ibro-rox/D4-Ganges/README.md

# D4-Ganges
we are making a sweet quadcopter
