ibro-rox/D4-Ganges/Admin/Module Design Proposals.docx

Module Design Proposals

Module Title: Control Module

People Involved: Lawrence, Ben, Joe

The Control Module is responsible for the main functions of the device, running the main PID control loop and interfacing with the gyroscope and accelerometer. The program loop is designed to be short enough to allow regular updating of motor speeds through PWM control of the ESCs. The base for this module is the ATMEGA32u4 of the Arduino Leonardo, chosen for the wide availability of sensor interface libraries and enough 16-bit timers to allow enough graduation in motor speeds for fine control of the device. This will interface with the Communications module through the UART protocol to receive the user input and will return the motor speed and device orientation for logging and telemetry. The ESCs isolate the high current power circuitry of the motors from the low current micro-controller, taking in low current PWM with a maximum 10% duty cycle and providing the 4 motors with a PWM signal at much higher currents.

Module Title: Sensing Module

People Involved: Ben, Joe

The sensing capabilities of the system is based around the MPU6050 gyroscope/accelerometer IMU and a Sharp GP2Y0A41SK0F infra-red proximity sensor. The MPU6050 has an onboard DMP (Digital Motion Processor) which will be used to relieve load on the Control Module Arduino by converting the raw data from the gyroscope into angles for yaw, pitch and roll on chip, before sending this data over an I2C bus ready for use in the stabilisation algorithm. The Infra-red sensor will be mounted on the base of the drone to detect low flight altitudes and semi-automate the landing procedure. The output of this sensor is an analogue voltage which will be fed into an ADC on the Commnunications Module Il Matto board, as this data is not necessary for stable flight.

Module Title: Communications Module

People Involved: Joel, Mohammed

The Communications module is based around the ATMEGA644p microcontroller on an ‘Il Matto’ breakout board. It functions as the main communications hub of the system, interfacing with the RFM12B-S2 transceivers over SPI to provide the uplink and downlink to the base station and controller. It will perform some basic processing of the instructions from the controller, passing them through to the control module to create a new setpoint for the controller. This interfacing with the command module will be done over UART, and will receive in return logging data from the IMU. This logging data will be periodically written to an SD card sharing the SPI bus and also transmitted back to the base station as telemetry information. The communications microcontroller will also be responsible for reading from the IR proximity sensors through its onboard ADCs and controlling the servo-powered cargo hook through a PWM data signal.

Module Title: Ground Control

People Involved: Mohammed, Joel

The Base Station of the system is formed around the core of another Il Matto ATMEGA644p board. It will take input from the user through a combination of joysticks and buttons on the HID (Human Interface Device) controller. The joysticks contain dual potentiometers, which will be directed into the ADCs of the Il Matto to extract values. There will also be a UART connection to a host PC to be able to update PID constant values without needing to reprogram the command module, as well as to make the display of telemetry and debug information easier to implement and use. The base station will be connected to a RFM12B-S2 radio transceiver module over an SPI bus to allow it to communicate with the quadcopter wirelessly while in flight.
