ibro-rox/D4-Ganges/Admin/presentation/Team_Ganges_Presentation.pptx

## D4 - System Design Exercise Project Itchen

Team Ganges
24/03/2017

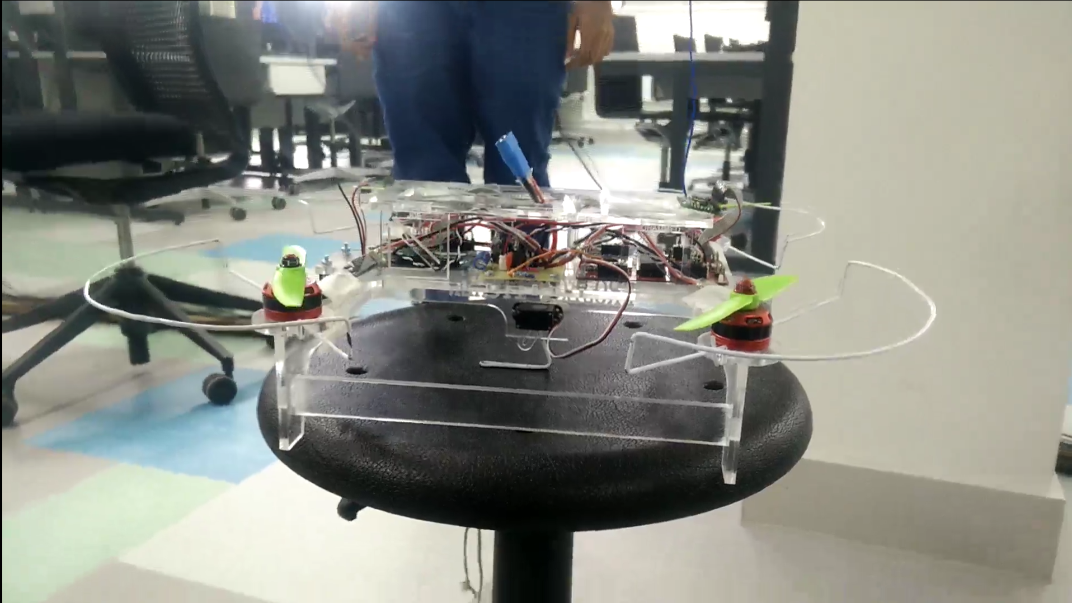
[picture p8: figure]

## Team Ganges

- Lawrence Gray – Control, Chassis Design
- Joe Hindmarsh – Control, Extra Features
- Joel Trickey – Communications, Encryption
- Mohammed Ibrahim – Communications, User Interface
- Ben Rowlinson – Team Leader, Integration

Notes: INSERT TEAM PHOTO HERE!

## The Brief

- “To design and build an unmanned aerial vehicle (UAV) that can pickup, carry and drop-off a cargo”

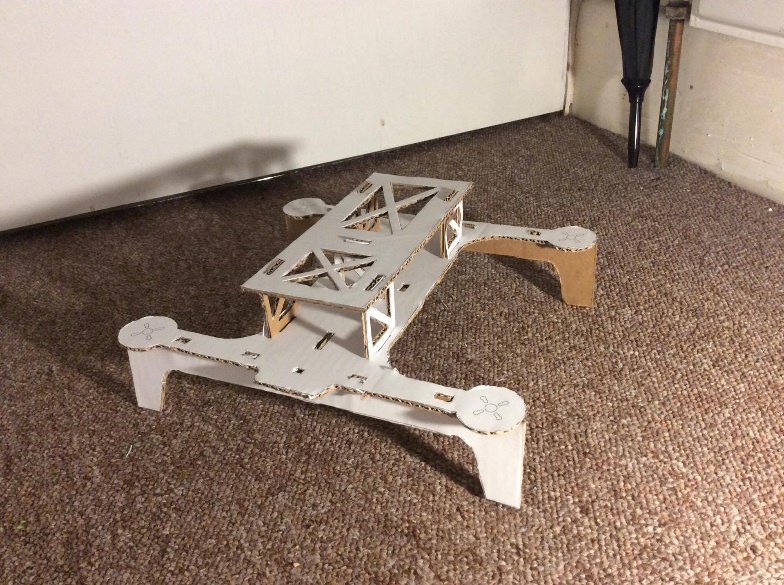
[picture p9: figure]
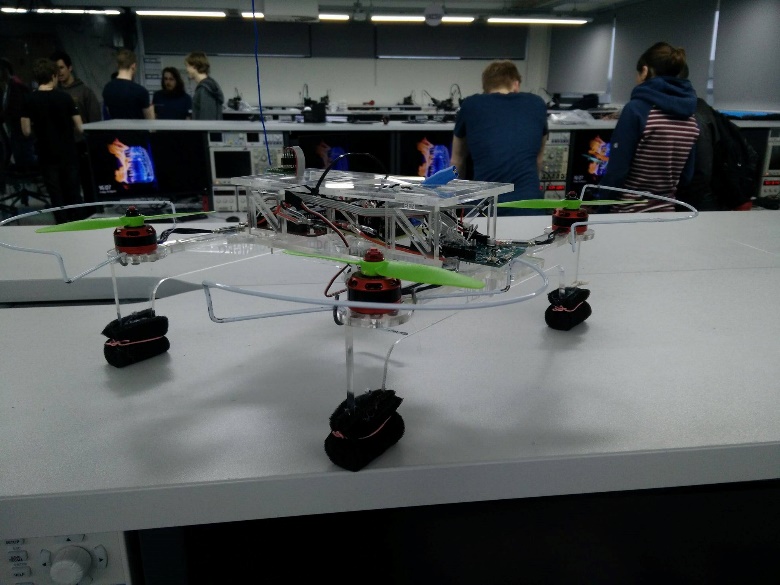
[picture p10: figure]
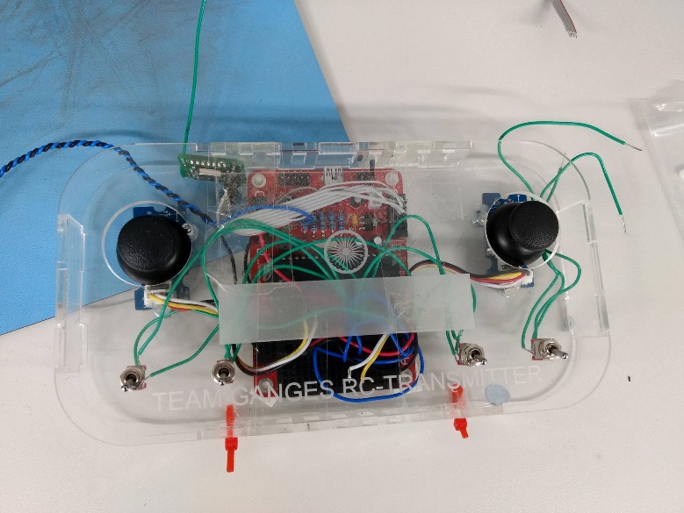
[picture p11: figure]

## Target Market

- Itchen required a solution which:
  - Has good cargo to UAV weight ratio
  - Is safe for the users
  - Is a low cost solution
- We delivered a UAV which incorporates:
  - Custom User interface
  - Two way communications
  - Automated Stabilisation
  - Assisted Cargo Acquisition

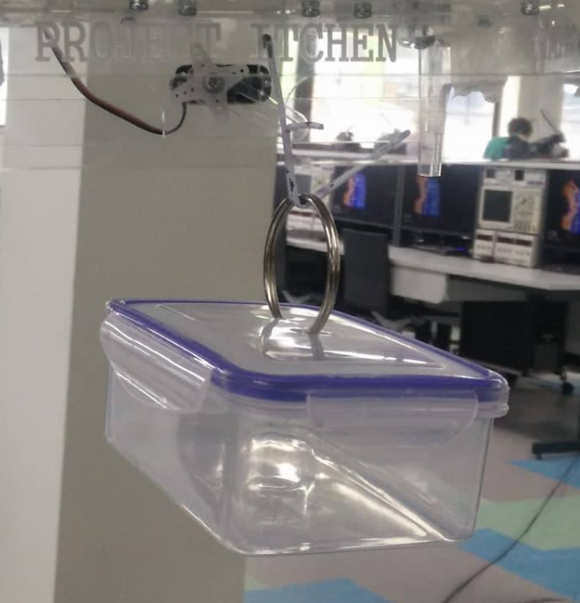
[picture p12: figure]

## Costings

- Retail at £300 gives a profit margin of 46.7%
- 1228 units to be sold to breakeven (at a yield of 90%)
- Expected that more UAVs needed for sustainable wide range delivery network

## Development

- Hardware Sourcing
- Software Development
- Chassis Manufacture
- System Integration
- Full system tuning/testing
- Documentation

## Problems

- Didn’t fly reliably
- Heavy - >900g
- Small Propellers

## Solutions and the Future

- Close to good stability

All image and content acknowledgement to Team Ganges

Notes: With a few more hours of tuning and debugging we could achieve stable flight
