ibro-rox/D4-Ganges/Admin/final_report/D4_Team_Report.pdf

# D4 Team Report

mi3g15

March 2017

## 1 Final Product Section

Table for comparison of achievements with the tasked specifications:

Specifications | Achievements
Arming system for the motors to ensure safety compliance | We made 4 propeller guards from reusable coat hang-ers by reshaping it to the right size and dimension and were proven to be reliable and cost effective.
Motor speed controlled by 1-2ms PWM ESCs - Imax:20 A | Achieved high resolution of motor speed control within 1-2ms using high resolution timers from the leonardo MCU.
RF modules operated using SPI Interface | Achieved this since we were able to receive data that was transmitted from base station il matto to drone il matto. This proves that the SPI works reliably for sending and retrieving data between the il matto and the RF modules.
On-board file logging to SD card | Unable to achieve due to lack of time and coding issues with writing data to the SD card.
I2C interface at 100 samples per sec with Gyroscope and accelerometer(MPU6050) with built in DMP | Achieved reading data from this sensor at the speci-fied rate.
Servo used for cargo acquisition-controlled by PWM | Achieved control of servo using PWM.
Laser- cut arcylic chassis and as-sembled using acrylic glue | Achieved successful construction for initial and final chassis designs.
I-style design for easier weight distribution and more carrying capacity | Achieved implementing this chassis design but in the final product, we added ’I’ supports to the centre as well as to the arms to make the chassis more robust to object/ground collision.
Reprogram the PID controller on the fly by changing K values wirelessly for faster tuning | Program has been developed on the base station to send k values but has be modified for sending these values while the drone is on ground only. Also this method of re tuning has not be used due to risk of a fault in wireless uplink and limited time for tuning of the PID controller.
Interfaced with the pilot using two X-Y joystick potentiometers, a bank of function switches, and a micro-controller | Achieved a remote controller module consisting of these components which has been designed, pro-grammed and tested.
Sharp GP2Y0A41SK0F IR sen-sor providing altitude sensing for telemetry with accuracy from 15 to 100 cm | Sensor has shown to work reliably for the specified range and also implemented receiving IR sensor data for telemetry.

## 2 Working of the Final Product

The remote controller interface consist of joystick potentiometers which are read into the atmega644p MCU using Analogue to Digital converter (ADC) interface. The values are then sent through SPI interface to

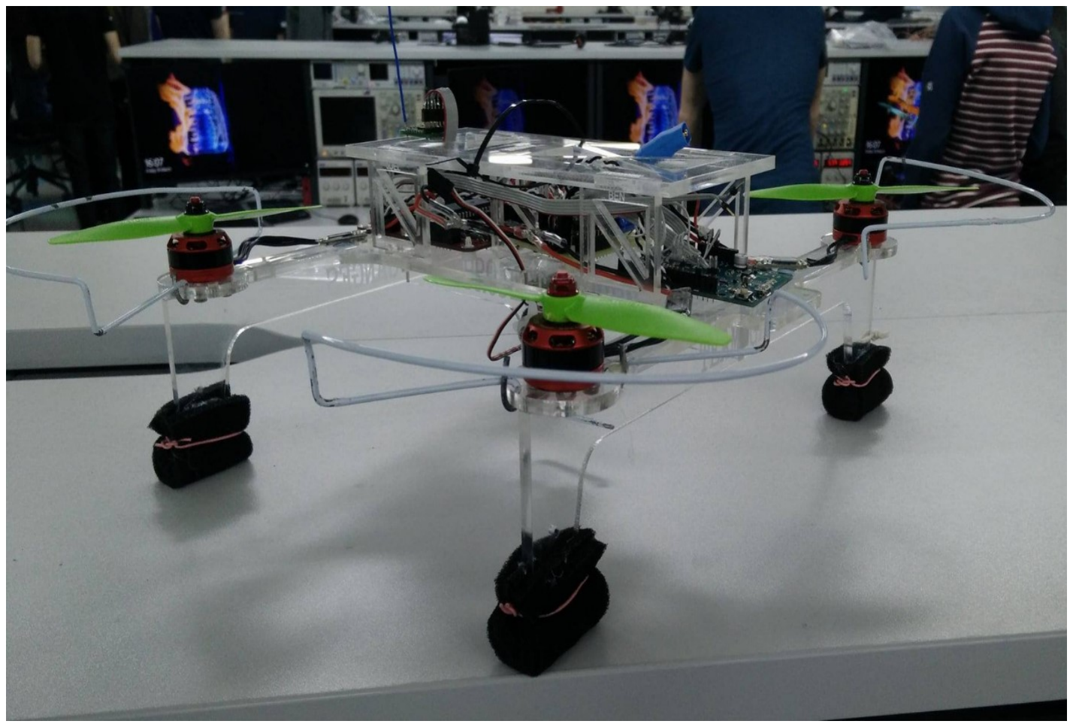
[picture p13: figure]

(a) Final build of the Human drone interface controller with implemented electronics inside an acrylic casing.
(b) Final build of the Quad copter drone consisting of the electronics based on design and specifications, moulded on to the main chassie design.

Figure 1: Final product images

the RF transceiver modules for wireless uplink of the joystick values to the drone. The RF transceiver on the drone then sends the received values to the atmega644p MCU on the drone through the same SPI interface. The same atmega MCU on the drone then sends these values to the arduino leonardo through UART interface. Finally the received joystick values in the leonardo get translated to the corresponding PWM output signals for controlling the speed of the 4 motors. A stabilization controller program is used in the leonardo which reads the data from the accelerometer/gyroscope sensor as feedback to ensure that the drone maintains stable flight. The serial cable in the remote controller is used to view telemetry of the power supply level on the drone and the IR sensor data through PUTTy terminal on the PC when one of the switches is in ’flight mode’ and allows you to enter PID values for yaw, pitch and roll for tuning the stabilization program on the drone when in ’PID mode’.

## 3 Extensions

- One of the features that was not achieved was the logging of telemetry data on to the SD card which could have been achieved if we were provided more time for it.
- Instead of using the PC as a User Interface for telemetry and PID tuning, an LCD screen could have been implemented to make the User interface more localised to the remote.
- Being able to overcome the limitation of the User interface for entering different range of PID values and able to tune the stabilization controller on the drone during its flight.
- Adding IR sensors to the front and bottom of the drone to allow it to detect obstacles and control its motors accordingly to avoid collision.
- Implementing an auto landing feature for the drone to use the bottom IR sensor to land itself safely. The 4th switch on the remote was meant to enable this operation, where when switched on, the drone would reject control commands from the controller and would self land onto ground by accordingly adjusting its motor speed to ensure secure landing.
