ibro-rox/D4-Ganges/Admin/Team_Ganges_Code_Listings.pdf

## 1 Control

## 1.1 Main File

#i n c l u d e ”PWM. h”

#i n c l u d e ”PID . h”

#i n c l u d e ” u t i l s . h”

PID yawPID ( 1 , 0 , 0 ) ; PID p i t c hPID ( 1 , 0 , 0 ) ; PID r o l l P I D ( 1 , 0 , 0 ) ;

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

}

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

// se n d t e l e m e t r y

}

## 1.2 PWM output Funtions

1 | #i n c l u d e ” D e f i n i t i o n s . h”
2 | #i n c l u d e ”PWM. h”
3 | #i n c l u d e ”A r d ui n o . h”
4 | v o i d i n i t p wm ( v o i d )
5 | {
6 | /∗ TIMER 1 ∗/
7 | DDRB |= | BV (PB5 ) ; /∗ PWM 1A o u t ( p i n 9 on p r o mi c r o ) ∗/
8 | DDRB |= | BV (PB6 ) ; /∗ PWM 1B o u t ( p i n 10 on p r o mi c r o ) ∗/
9 | DDRB |= | BV (PB7 ) ; /∗ PWM 1C o u t ( non e x i s t a n t on p r o mi c r o ) ∗/
10 | TCCR1A = | BV (WGM11) | /∗ f a s t PWM/MAX ∗/
11 | BV (WGM12) | /∗ f a s t PWM/MAX ∗/
12 | BV (WGM13) | /∗ f a s t PWM/MAX ∗/
13 | BV (COM1A1) | /∗ A o u t p u t e n a b l e d ∗/
14 | BV (COM1B1) | /∗ C o u t p u t e n a b l e d ∗/
15 | BV (COM1C1) ; /∗ B o u t p u t e n a b l e d ∗/
16 | TCCR0B = | BV ( CS11 ) | ; /∗ /8 p r e s c a l i n g ∗/
17 | ICR1 = TIMER TOP ;
18 | /∗ TIMER 3 ∗/
19 | DDRC |= | BV (PC6 ) ; /∗ PWM 3A o u t ( p i n 5 on p r o mi c r o ) ∗/
20 | TCCR3A = | BV (WGM31) | /∗ f a s t PWM/MAX ∗/
21 | BV (WGM32) | /∗ f a s t PWM/MAX ∗/
22 | BV (WGM33) |
23 | BV (COM3A1) ; /∗ A o u t p u t e n a b l e d ∗/
24 | TCCR3B = | BV ( CS31 ) | ;
25 | ICR3 = TIMER TOP ;
26 | pwm duty (LEFT FRONT MOTOR, MIN MOTOR SPEED) ;
27 | pwm duty (RIGHT FRONT MOTOR, MIN MOTOR SPEED) ;
28 | pwm duty (LEFT REAR MOTOR, MIN MOTOR SPEED) ;
29 | pwm duty (RIGHT REAR MOTOR, MIN MOTOR SPEED) ;
30 | }

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

38
39 | s w i t c h ( motor )
40 | {
41 | c a s e LEFT FRONT MOTOR:
42 | OCR1A = d u ty ;
43 | c a s e RIGHT FRONT MOTOR:
44 | OCR1B = d u ty ;
45 | c a s e LEFT REAR MOTOR:
46 | OCR1C = d u ty ;
47 | c a s e RIGHT REAR MOTOR :
48 | OCR3A = d u ty ;
49 | }
50 | }

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

62 | CCW m o t o r s | D,B

63
64 | | F r o n t
65 | | +1 p i t c h
66 | C | D
67 | −1 r o l l | \−/ | +1 r o l l | r i g h t
68 | | /−\
69 | B | A
70 | | −1 p i t c h

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

## 1.3 PID Class (Found online)

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

20
21 | //#i n c l u d e ”WProgram . h”
22 | #i n c l u d e ”PID . h”

23
24 | PID : : PID ( ) {
25 | i S t a t e = 0 ;
26 | l a s t = 0 ;

27
28 | p g a i n = 0 ;
29 | i g a i n = 0 ;
30 | d g a i n = 0 ;
31 | }

32
33 | PID : : PID ( f l o a t p , f l o a t i , f l o a t d ) {
34 | PID ( ) ;

35
36 p g a i n = p ;

37 | i g a i n = i ;
38 | d g a i n = d ;
39 | }

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

}

v o i d PID : : r e s e t E r r o r ( ) {
i S t a t e = 0 ;

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

## 1.4 Other utilities for PID code

#i n c l u d e ” u t i l s . h”

#i n c l u d e ” D e f i n i t i o n s . h”

f l o a t rawToAngle ( i n t c o n t r o l I n )

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

}

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

}
r e t u r n 0 ;

}

## 2 Sensing

## 2.1 Gyroscope (example code we will use for getting angles from gyro)

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

33
34 | THE SOFTWARE I S PROVIDED ”AS I S ” , WITHOUT WARRANTY OF ANY KIND , EXPRESS OR
35 | IMPLIED , INCLUDING BUT NOT LIMITED TO THE WARRANTIES OF MERCHANTABILITY,
36 | FITNESS FOR A PARTICULAR PURPOSE AND NONINFRINGEMENT. IN NO EVENT SHALL THE
37 | AUTHORS OR COPYRIGHT HOLDERS BE LIABLE FOR ANY CLAIM , DAMAGES OR OTHER
38 | LIABILITY , WHETHER IN AN ACTION OF CONTRACT, TORT OR OTHERWISE, ARISING FROM,
39 | OUT OF OR IN CONNECTION WITH THE SOFTWARE OR THE USE OR OTHER DEALINGS IN
40 | THE SOFTWARE.
41 | ===============================================
42 | ∗/

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

63

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

| b o o l b l i n k S t a t e = f a l s e ;

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

141
142 | // p a c k e t s t r u c t u r e f o r I n v e n S e n s e t e a p o t demo
143 | u i n t 8 t t e a p o t P a c k e t [ 1 4 ] = { ’ $ ’ , 0 x02 , 0 , 0 , 0 , 0 , 0 , 0 , 0 , 0 , 0 x00 , 0 x00 , ’ \ r ’ , ’ \n
| ’ } ;

144

145

146
147 | // ================================================================
148 | // === | INTERRUPT DETECTION ROUTINE | ===
149 | // ================================================================

150

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

156

157

158
159 | // ================================================================
160 | // === | INITIAL SETUP | ===
161 | // ================================================================

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

pinMode (INTERRUPT PIN , INPUT ) ;

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

}

// c o n f i g u r e LED f o r o u t p u t pinMode ( LED PIN , OUTPUT) ;

}

// ================================================================
248 | // === | MAIN PROGRAM LOOP | ===
// ================================================================
| v o i d l o o p ( ) {

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

// .

// .

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

// .

// .

// .

}

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

#i f d e f OUTPUT READABLE QUATERNION

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

#i f d e f OUTPUT READABLE EULER

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

#i f d e f OUTPUT READABLE YAWPITCHROLL

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

#i f d e f OUTPUT READABLE REALACCEL

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

#i f d e f OUTPUT READABLE WORLDACCEL

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

## 2.2 IR sensor

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

9
10 | v o i d i n i t a d c ( v o i d )
11 | {
12 | ADCSRA |= | BV (ADPS2) | | BV (ADPS1) | | BV (ADEN) ;
13 | ADMUX |= | BV (REFS0 ) ;
14 | }

15
16 | u i n t 1 6 t r e a d a d c ( v o i d )
17 | {
18 | ADCSRA |= | BV (ADSC) ;
19 | w h i l e (ADCSRA & BV (ADSC) ) ;

20
21 | r e t u r n ADC;
22 | }

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

39
40 | f o r ( ; ; )
41 | {
42 | | r e s u l t = r e a d a d c ( ) ;

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

48
49 | | d e l a y m s ( 1 0 0 0 ) ;
50 | }
51 | }

## 3 Communication

## 3.1 Communications Code from Base station

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

8
9 u i n t 8 t e n c r y p t i o n k e y ;

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

16
17 e n c r y p t i o n k e y = 5 ;

18
19 | // Send t e s t da ta
20 | u i n t 1 6 t t e s t d a t a = 0 ;

21
22 | w h i l e ( 1 )
23 | {
24 | | r f m 1 2 t i c k ( ) ;

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

32
33 | }
34 | w h i l e ( 1 ) { } ;
35 | }

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

∗/
v o i d S e n d da ta ( u i n t 8 t ty pe , u i n t 1 6 t da ta )

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

// E n c r y p t da ta
#i f ENCRYPTION ENABLED

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

}

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

| }

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

| }

## 3.2 Communications code from the drone

#i n c l u d e <a v r / i o . h>

#i n c l u d e <a v r / i n t e r r u p t . h>

#i n c l u d e <u t i l / d e l a y . h>

#i n c l u d e ” r fm12 . h”

#i n c l u d e ” drone comms . h”

i n t main ( v o i d )

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

w h i l e ( 1 )

{
r f m 1 2 t i c k ( ) ;

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

#i f UPLINK TEST

// Send da ta t o UART
#e n d i f

}

}

}

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

#i f ENCRYPTION ENABLED

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

}

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

## 3.3 Packet encryption and encoding

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

6
7 | // Mohammed ’ s UART code
8 | #d e f i n e BAUD 9600 | | // d e f i n e baud
9 | #d e f i n e BAUDRATE ( ( F CPU ) / (BAUD∗16UL) −1) | // s e t baud r a t e v a l u e f o r
| UBRR

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

20
21 | UCSR0C = BV ( UCSZ00 ) | | BV ( UCSZ01 ) ; // 8 b i t s , USBS1 = 0 f o r 1 s t o p b i t

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

32 | UDR0 = da ta ;
33 | }

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

40
41 | v o i d t e s t e n c o d e ( )
42 | {
43 | // Encode
44 | s e n d s t r i n g ( ” E nc o di n g da ta \n” ) ;
45 | // 998 = 11 1110 0110
46 | u i n t 1 6 t ADCoutput ;
47 | ADCoutput = 9 9 8;
48 | // 1110 0110
49 | u i n t 8 t l s b 8 ;
50 | l s b 8 = ADCoutput ;
51 | // 11 0000 0000
52 | u i n t 1 6 t msb2 ;
53 | msb2 = ADCoutput − l s b 8 ;
54 | // 00 0000 0011
55 | msb2 = msb2 >> 8 ;
56 | // 0000 1011
57 | u i n t 8 t p a c k e t t y p e ;
58 | p a c k e t t y p e = ( 2 << 2 ) + msb2 ;

59
60 // Se n t da ta : [ 0 0 0 0 1 0 1 1] [ 1 1 1 0 0 1 1 0]

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

72
73 | c h a r sendDa ta [ 3 0 ] ;
74 | s p r i n t f ( sendData , ”Decoded da ta : %d\n” , d e c o d e d da ta ) ;
75 | s e n d s t r i n g ( sendDa ta ) ;
76 | }

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

138
139 | i n t main ( v o i d )
140 | {
141 | i n i t u a r t 1 ( ) ;

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

152 }

153
154 | w h i l e ( 1 ) { } ;
155 | }

## 4 Ground Control

## 4.1 Testing adc reads for using Joystick potentiometers

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

22

23
24 | // I n ADCSRA E na bl e ADC ( s e t ADEN) and p r e s c a l e r o f 64
25 | ADCSRA |= | BV (ADEN) | | BV (ADPS2) | | BV (ADPS1) ;
26 | }
27 | u i n t 1 6 t a d c r e a d ( i n t n ) // [ 1 ]
28 | {
29 | ADMUX = n ; // r e p r e s e n t s PA2
30 | // s t a r t c o n v e r s i o n
31 | ADCSRA |= | BV (ADSC) ;
32 | // w a i t f o r c o n v e r s i o n t o c om pl e t e
33 | // w h i l e ( ! (ADCSRA & BV(ADIF) ) ) { } ;
34 | w h i l e (ADCSRA & BV (ADSC) ) ;
35 | ADC = (ADCH << 8 ) | ADCL; // [ 1 ]
36 | r e t u r n ADC;
37 | }
38 | #d e f i n e BAUD 9600 | // d e f i n e baud
39 | #d e f i n e BAUDRATE ( ( F CPU ) / (BAUD∗16UL) −1) | // s e t baud r a t e v a l u e f o r
| UBRR

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

50
51 | UCSR0C = BV ( UCSZ00 ) | | BV ( UCSZ01 ) ; // 8 b i t s , USBS1 = 0 f o r 1 s t o p b i t

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

}

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

134
135 | }
136 | }

## 4.2 Testing User Interface code in the base station controler

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

15
16 | #d e f i n e PWM DUTY MAX 240
17 | #d e f i n e PWM DUTY MIN 0
18 | #d e f i n e PWM PRESCALER 8UL
19 | #d e f i n e PWM FREQUENCY 50
20 | #d e f i n e PWM OFFSET 0
21 | // ∗∗∗∗∗∗∗∗∗∗

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

26
27 | // I n ADCSRA E na bl e ADC ( s e t ADEN) and p r e s c a l e r o f 64
28 | ADCSRA |= | BV (ADEN) | | BV (ADPS2) | | BV (ADPS1) ;
29 | }
30 | v o i d i n i t p wm ( v o i d )
31 | {
32 | /∗ TIMER 2 ∗/

33 | DDRD |= | BV (PD6) ; /∗ PWM o u t ∗/
34 | DDRD |= | BV (PD7) ; /∗ i n v . PWM o u t ∗/

35

36
37 | TCCR2A = BV (WGM20) | /∗ f a s t PWM/MAX ∗/
38 | BV (COM2A1) ; /∗ A o u t p u t ∗/
39 | TCCR2B = BV ( CS21 ) | |
40 | BV ( CS22 ) ; | /∗ 1/256 p r e s c a l i n g ∗/
41 | }
42 | u i n t 1 6 t a d c r e a d ( i n t n ) // [ 1 ]
43 | {
44 | ADMUX = n ; // r e p r e s e n t s PA2
45 | // s t a r t c o n v e r s i o n
46 | ADCSRA |= | BV (ADSC) ;
47 | // w a i t f o r c o n v e r s i o n t o c om pl e t e
48 | // w h i l e ( ! (ADCSRA & BV(ADIF) ) ) { } ;
49 | w h i l e (ADCSRA & BV (ADSC) ) ;
50 | ADC = (ADCH << 8 ) | ADCL; // [ 1 ]
51 | r e t u r n ADC;
52 | }
53 | v o i d pwm duty ( u i n t 8 t d u ty ) // f rom s e r v o . c
54 | {
55 | d u ty = d u ty > PWM DUTY MAX ? PWM DUTY MAX : d u ty ;
56 | d u ty = d u ty < PWM DUTY MIN ? PWM DUTY MIN : d u ty ;
57 | // p r i n t f ( ”\nPWM=%3u | ==> | ” , d u ty ) ;
58 | OCR2A = d u ty ;
59 | }
60 | v o i d i n i t u a r t 1 ( ) // i n i t i a l i z e UART
61 | {
62 | // 1 . s e t t h e baud r a t e , l e t s c o n f i g u r e t o 9 6 0 0;
63 | // s e t t h e baud r a t e r e g i s t e r s Re f : [ 1 ] , [ 2 ]
64 | UBRR0H = BAUDRATE >> 8 ; // UBRRnH i s 8 b i t s l e f t
65 | UBRR0L = BAUDRATE;

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

69
70 | UCSR0C = BV ( UCSZ00 ) | | BV ( UCSZ01 ) ; // 8 b i t s , USBS1 = 0 f o r 1 s t o p b i t

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

144
145 }

146
147 | i n t main ( )
148 | {
149 | i n i t u a r t 1 ( ) ;

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

161
162 | w h i l e ( 1 )
163 | {

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

200

201
202 | }
203 | }

## 5 Chassis Design

## 5.1 Servo code for hook

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

9

10

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

15
16 | #d e f i n e PWM DUTY MAX 240
17 | #d e f i n e PWM DUTY MIN 0
18 | #d e f i n e PWM PRESCALER 8UL
19 | #d e f i n e PWM FREQUENCY 50
20 | #d e f i n e PWM OFFSET 0

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

27
28 | i n t main ( v o i d )
29 | {

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

34
35 | u i n t 1 6 t a d c v a l u e ;
36 | u i n t 8 t pwm value ;

37
38 | w h i l e ( 1 )
39 | {
40 | a d c v a l u e = a d c r e a d ( ) ;
41 | pwm value = ( u i n t 8 t ) ( a d c v a l u e / 4 ) + PWM OFFSET;
42 | pwm duty ( pwm value ) ;
43 | d e l a y m s ( 1 0 0 ) ;
44 | }
45 | }

46

47

48
49 | v o i d i n i t p wm ( v o i d )
50 | {
51 | /∗ TIMER 2 ∗/
52 | DDRD |= | BV (PD6) ; /∗ PWM o u t ∗/
53 | DDRD |= | BV (PD7) ; /∗ i n v . PWM o u t ∗/

54

55
56 | TCCR2A = BV (WGM20) | /∗ f a s t PWM/MAX ∗/
57 | BV (COM2A1) ; /∗ A o u t p u t ∗/
58 | TCCR2B = BV ( CS21 ) | |
59 | BV ( CS22 ) ; | /∗ 1/256 p r e s c a l i n g ∗/
60 | }

61
62 v o i d pwm duty ( u i n t 8 t d u ty )

63 | {
64 | d u ty = d u ty > PWM DUTY MAX ? PWM DUTY MAX : d u ty ;
65 | d u ty = d u ty < PWM DUTY MIN ? PWM DUTY MIN : d u ty ;
66 | p r i n t f ( ”\nPWM=%3u | ==> | ” , d u ty ) ;
67 | OCR2A = d u ty ;
68 | }

69
70 | v o i d i n i t a d c ( v o i d )
71 | {
72 | /∗ REFSx = 0 : S e l e c t AREF a s r e f e r e n c e
73 | ∗ ADLAR = 0 : R i g h t s h i f t r e s u l t
74 | ∗ | MUXx = 0 : D e f a u l t t o c h a n n e l 0
75 | ∗/
76 | ADMUX = 0 x00 ;
77 | /∗ | ADEN = 1 : E na bl e t h e ADC
78 | ∗ ADPS2 = 1 : C o n f i g u r e ADC p r e s c a l e r
79 | ∗ ADPS1 = 1 : F ADC = F CPU / 64
80 | ∗ ADPS0 = 0 : | = 1 8 7. 5 kHz
81 | ∗/
82 | ADCSRA = BV (ADEN) | | BV (ADPS2) | | BV (ADPS1) ;
83 | }

84

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

95
96 | p r i n t f ( ”ADC=%4d” , a d c i n ) ;

97
98 | r e t u r n a d c i n ;
99 | }

## 5.2 Laser printing design

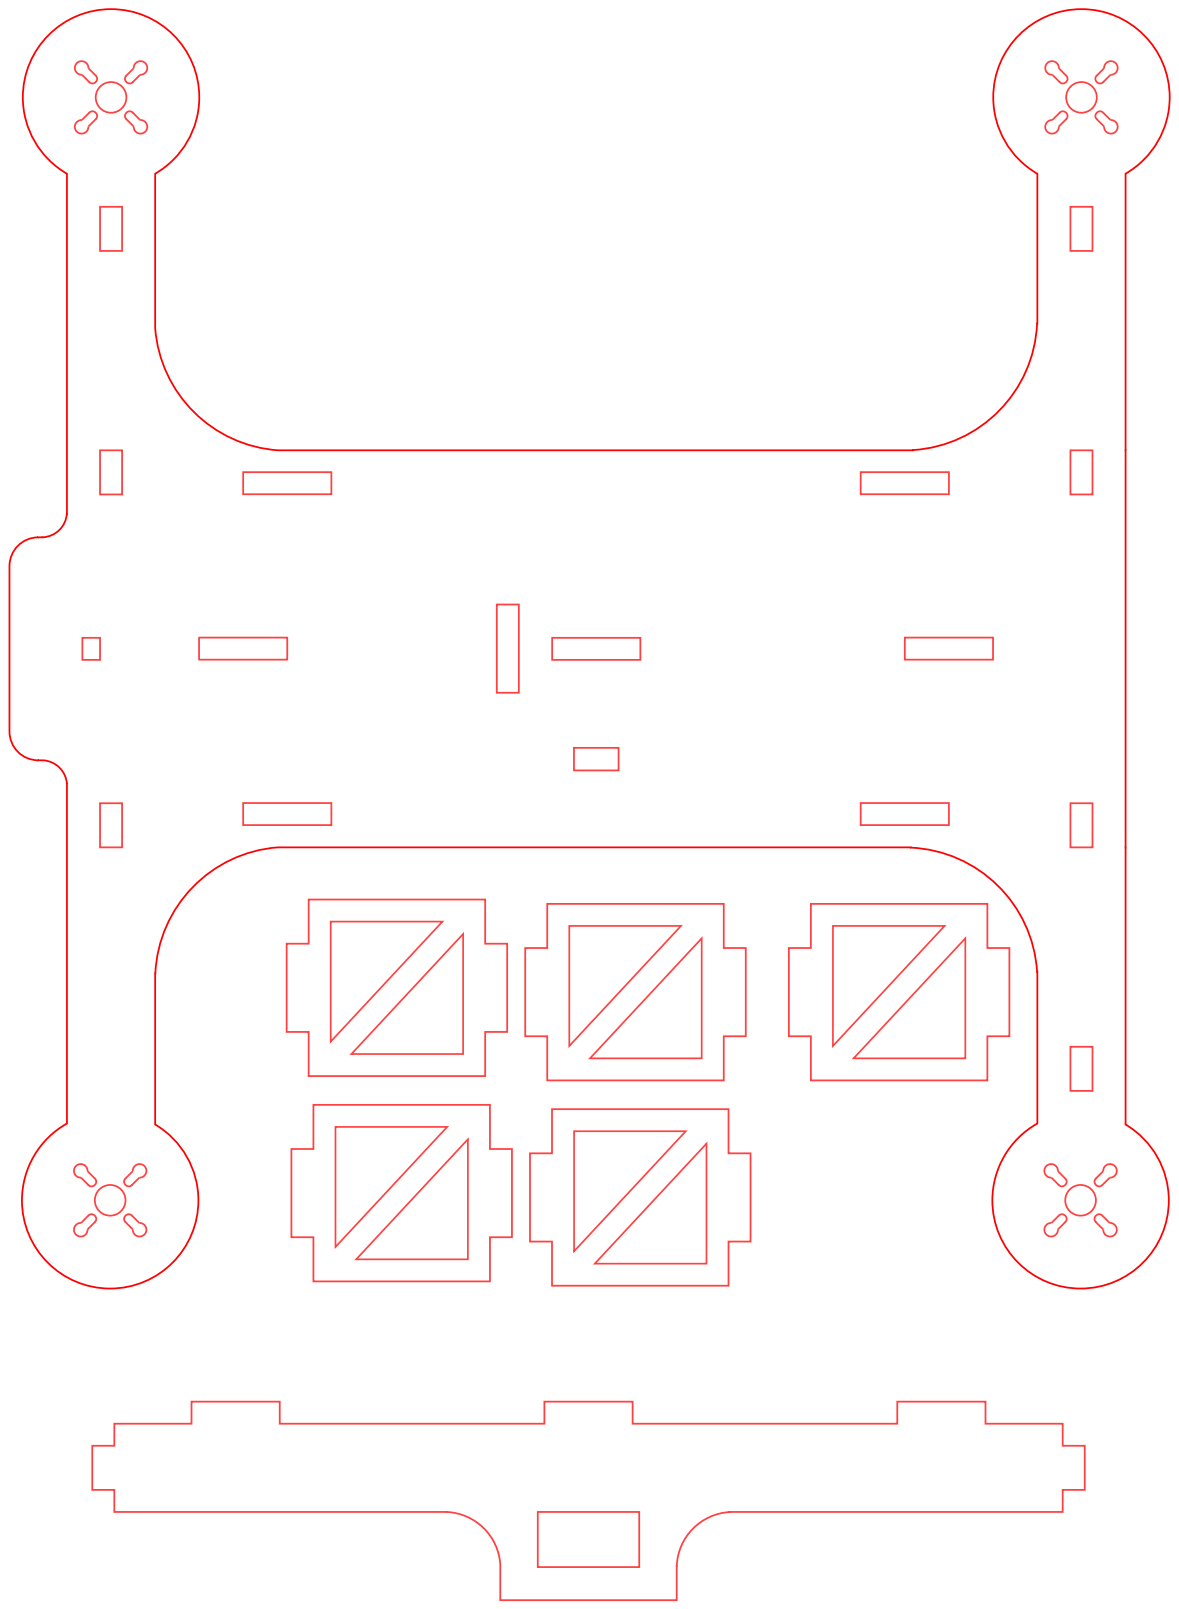
[picture p20: page 27]

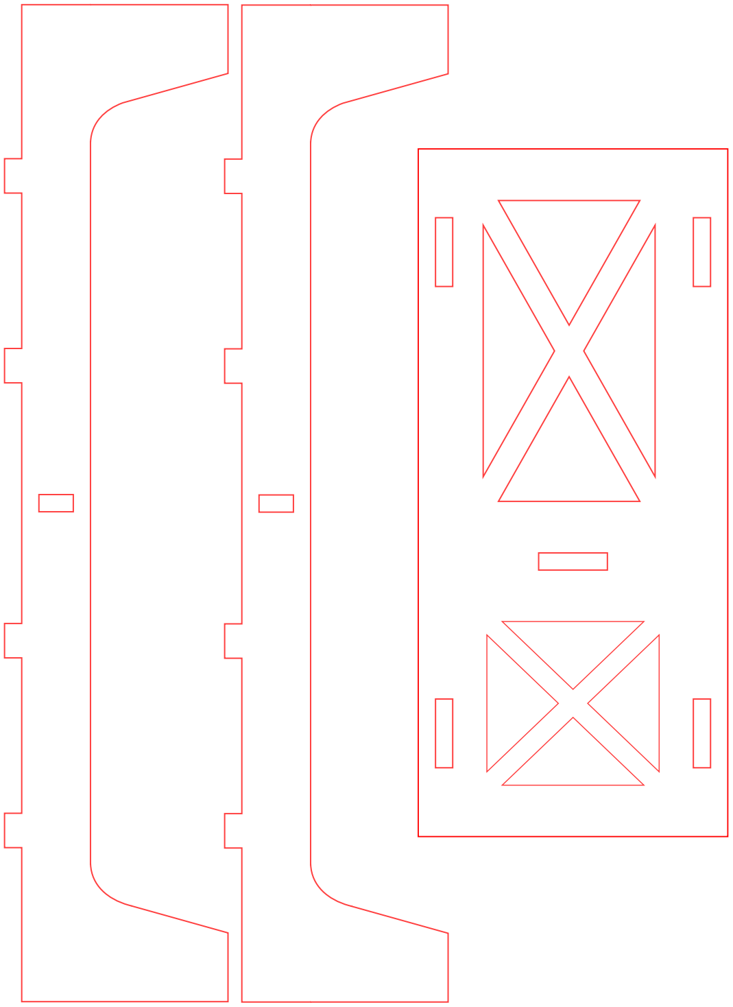
[picture p21: figure]
