ibro-rox/D4-Ganges/Admin/final_report/PCF1.pdf

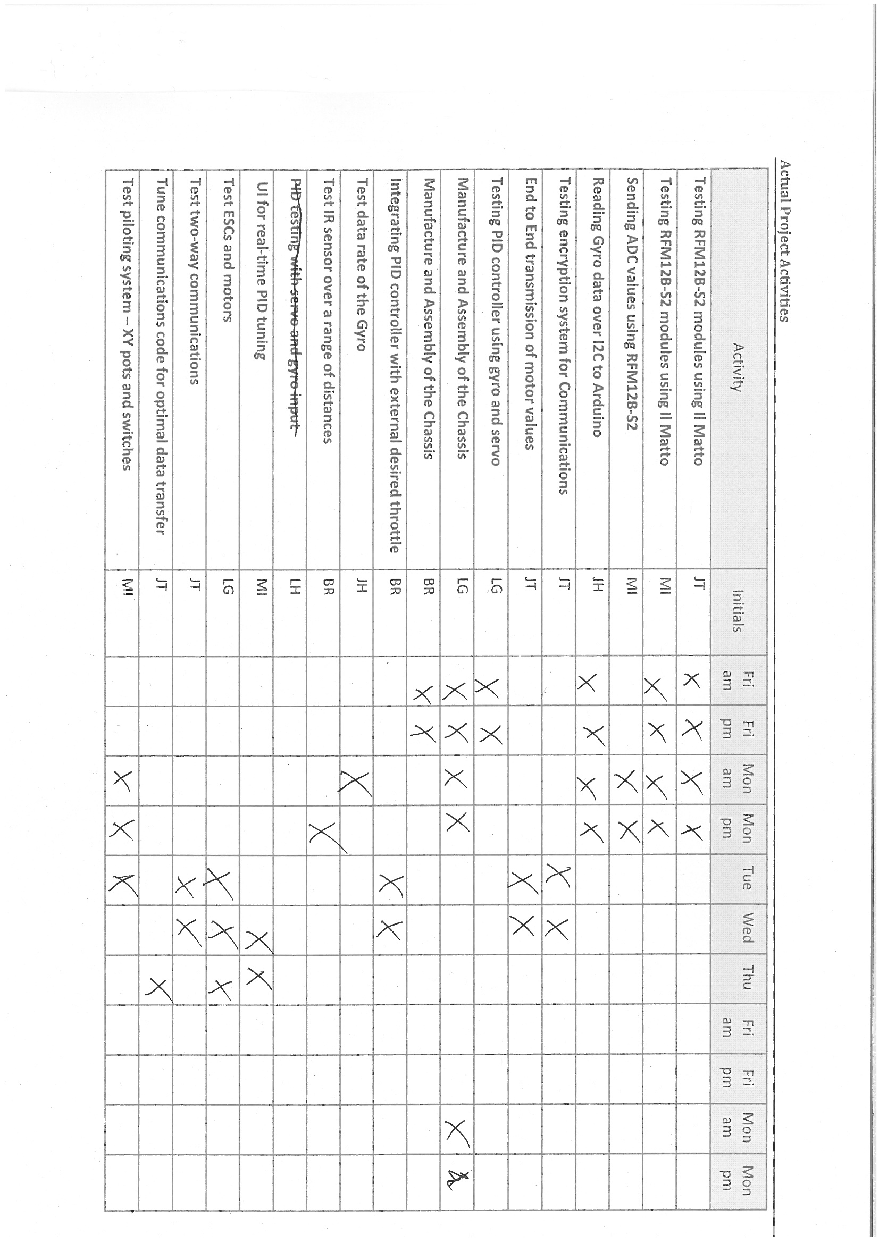
[picture p22: page 1]
