ibro-rox/D4-Ganges/Admin/final_report/PCF2.pdf

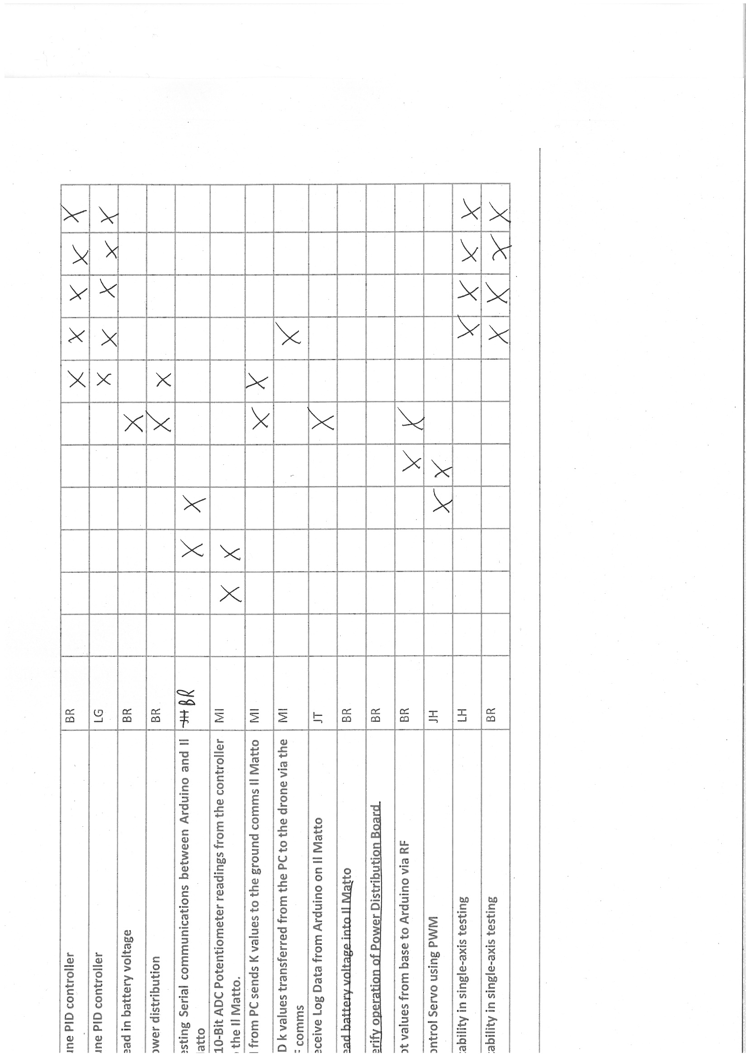
[picture p23: page 1]
