ibro-rox/D4-Ganges/Admin/final_report/Design_Completion1.pdf

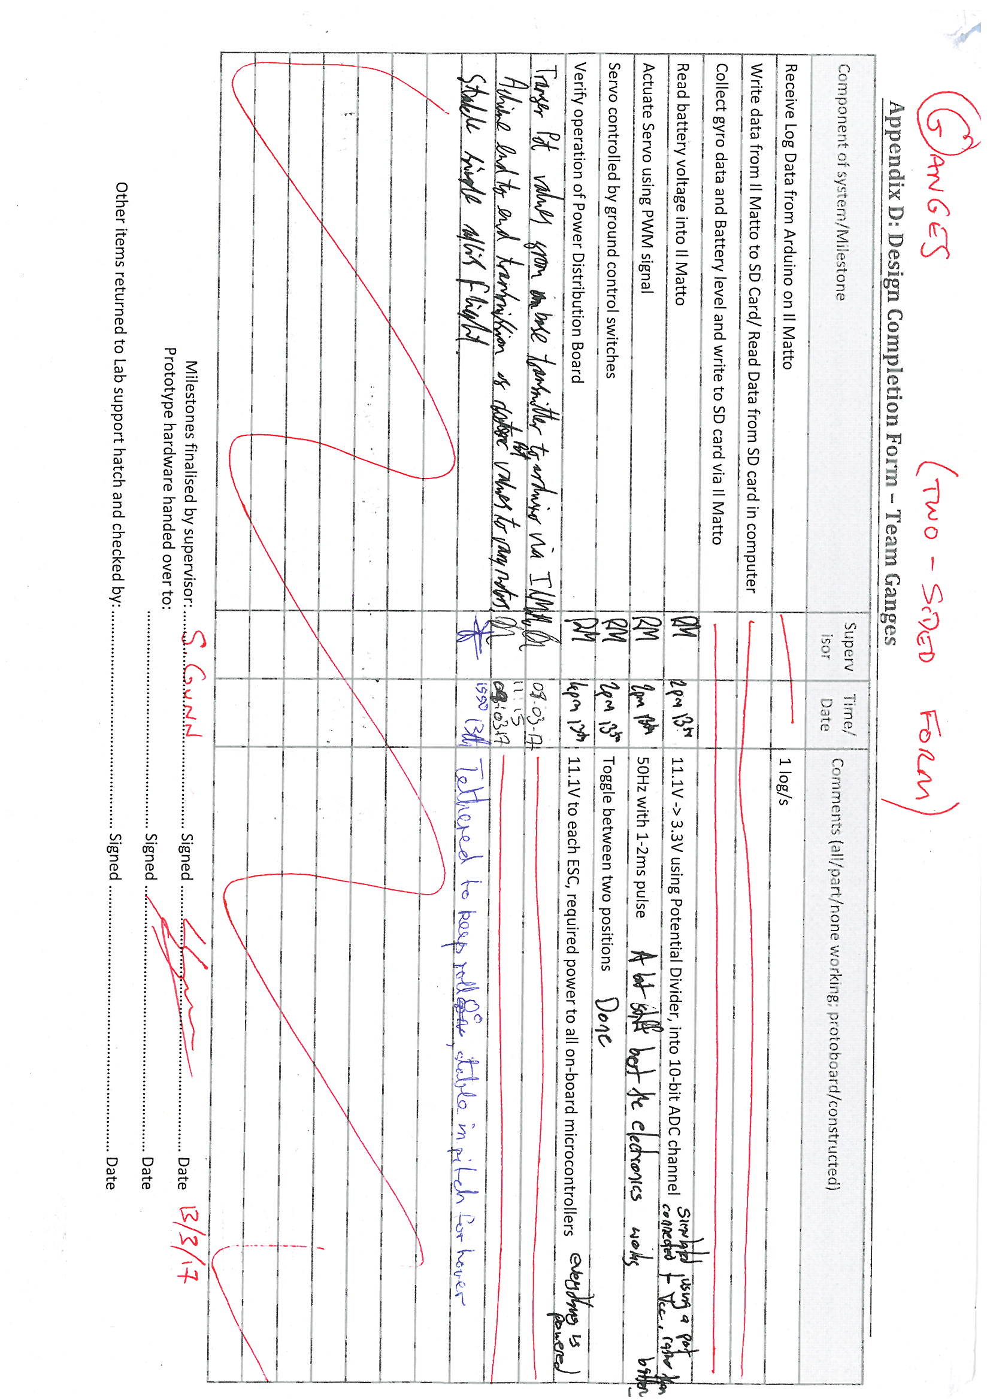
[picture p24: page 1]
