ibro-rox/D4-Ganges/Admin/final_report/Design_Completion2.pdf

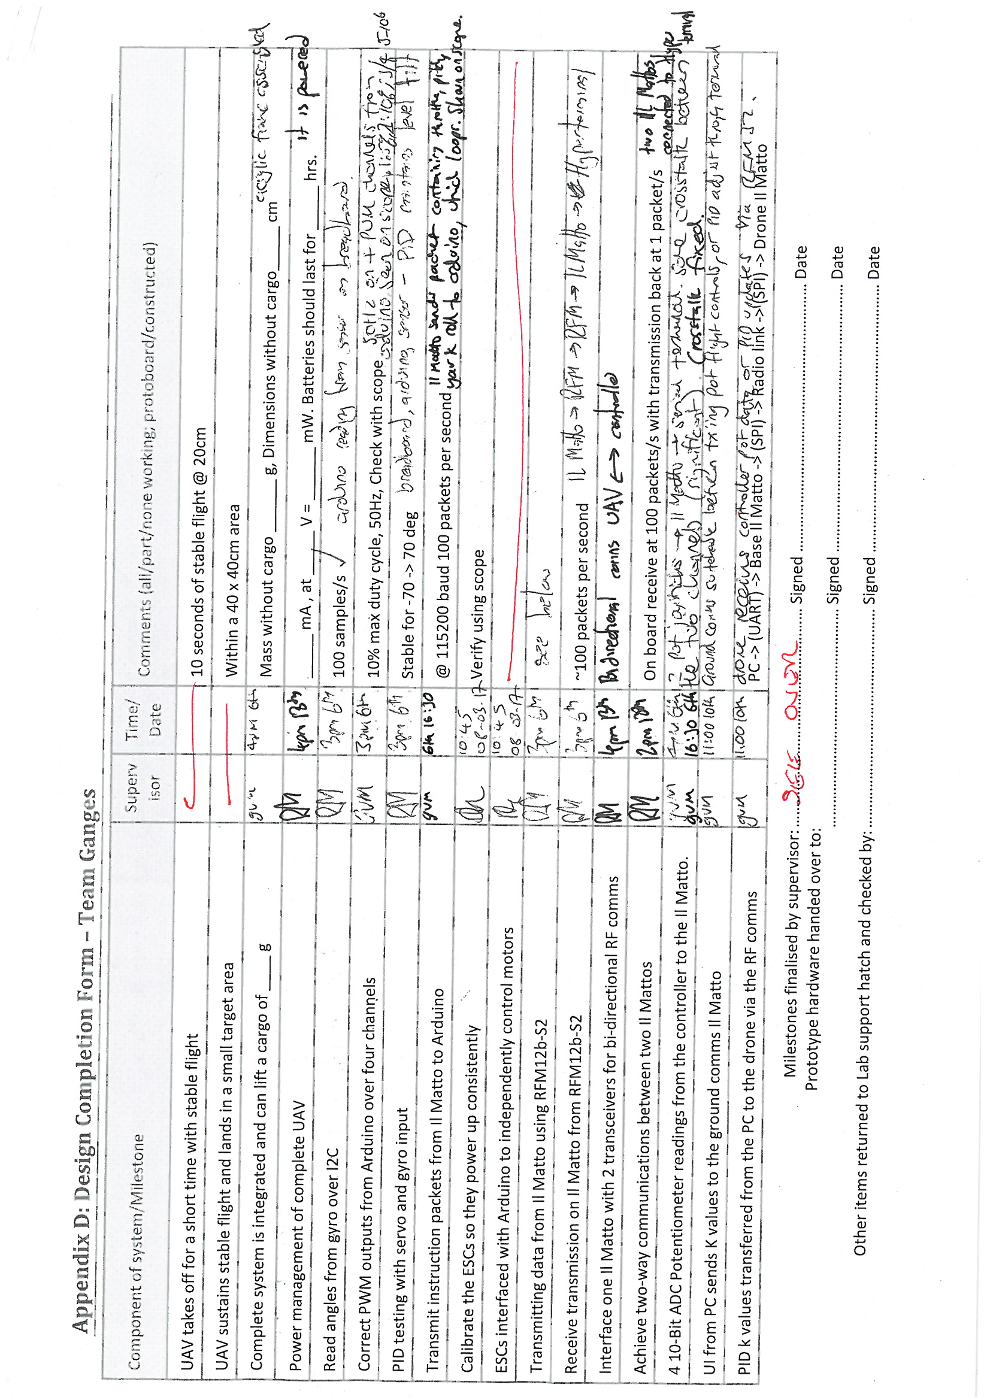
[picture p25: page 1]
