ibro-rox/D4-Ganges/Admin/final_report/Ben/57600_baud_1_char_y.png

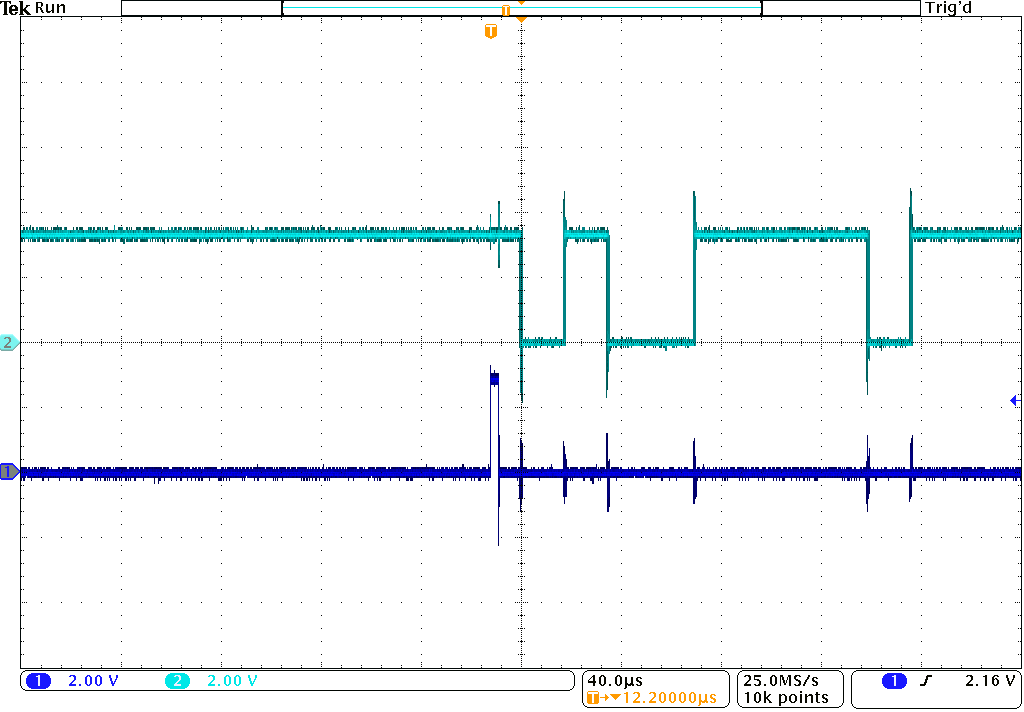
Admin/final_report/Ben/57600_baud_1_char_y.png
