ibro-rox/D4-Ganges/Admin/final_report/Ben/57600_baud_3_dig_512.png

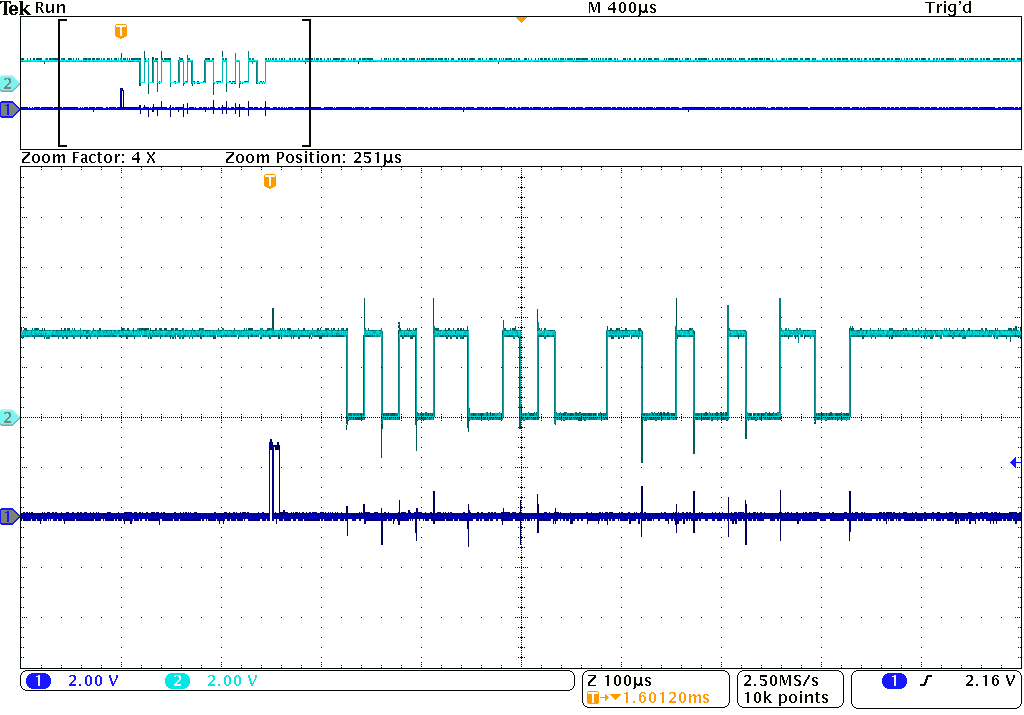
Admin/final_report/Ben/57600_baud_3_dig_512.png
