ibro-rox/D4-Ganges/Joe/i2c protocol.PNG

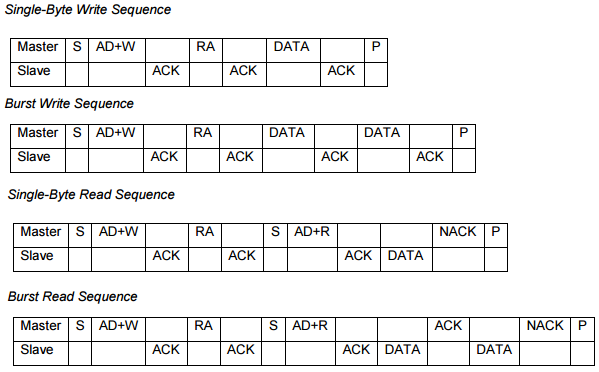
Joe/i2c protocol.PNG
