ibro-rox/D4-Ganges/Admin/Ganges_Requisitions.xlsx

Group: Ganges |  | Project leader: Ben Rowlinson | Supplier: Unmanned Tech
Column1 | Column2 | Column3 | Column4 | Column5 | Column6
Quantity | Suppliers stock code | Description | Unit price (ex. VAT) | Total price (ex. VAT) | In stock
4 | B60-1C3-730 | CHAOS BLHELI_S DSHOT ESC 20A | 4.99 | 19.96 | Yes
2 | 1AE-568-132 | BG2204 2300KV BRUSHLESS MOTOR FOR EACHINE RACER 250 Clockwise(CCW Shaft) | 4.99 | 9.98 | Yes
2 | 1AE-568-134 | BG2204 2300KV BRUSHLESS MOTOR FOR EACHINE RACER 250 Counter-Clockwise (CW Shaft) | 4.99 | 9.98 | Yes
2 | COM90133P | Grove - Thumb Joystick | 4.33 | 8.66 | Yes
1 | 69A-D8F-842 | 5X30 ABS PLASTIC PROPELLER PACK (4 X CCW, 4 X CW) Green | 1.04 | 1.04 | Yes
1 | XT60FMPT | FEMALE XT60 WIRE - 10CM | 0.83 | 0.83 | Yes
1 | EC3 | EC3 Connectors (Pack of 5) | 2.92 | 2.92 | Yes
1 | TA-45C-1550-3S1P | TATTU 1550MAH 11.1V 45C 3S1P LIPO BATTERY PACK | 12.49 | 12.49 | Yes
Group: Ganges |  | Project leader: Ben Rowlinson | Supplier: Farnell
Column1 | Column2 | Column3 | Column4 | Column5 | Column6
Quantity | Suppliers stock code | Description | Unit price (ex. VAT) | Total price (ex. VAT) | In stock
1 | 2133070 | Arduino Leonardo, ATmegaU4 | 15.42 | 15.42 | Yes
Group: Ganges |  | Project leader: Ben Rowlinson | Supplier: ECS
Column1 | Column2 | Column3 | Column4 | Column5 | Column6
Quantity | Suppliers stock code | Description | Unit price (ex. VAT) | Total price (ex. VAT) | In stock
4 |  | RFM12B-S2 transceiver modules | 0 | 0 | Yes
1 |  | SD-Card adaptation for Il Matto | 0 | 0 | Yes
? |  | Stripboard | 0 | 0 | Yes
? |  | Various E12 resistors/capacitors | 0 | 0 | Yes
1 |  | LiPo battery charger for 3 cell | 0 | 0 | Yes
