ibro-rox/D4-Ganges/Cargo Acquisition/HookAssembly.SLDASM

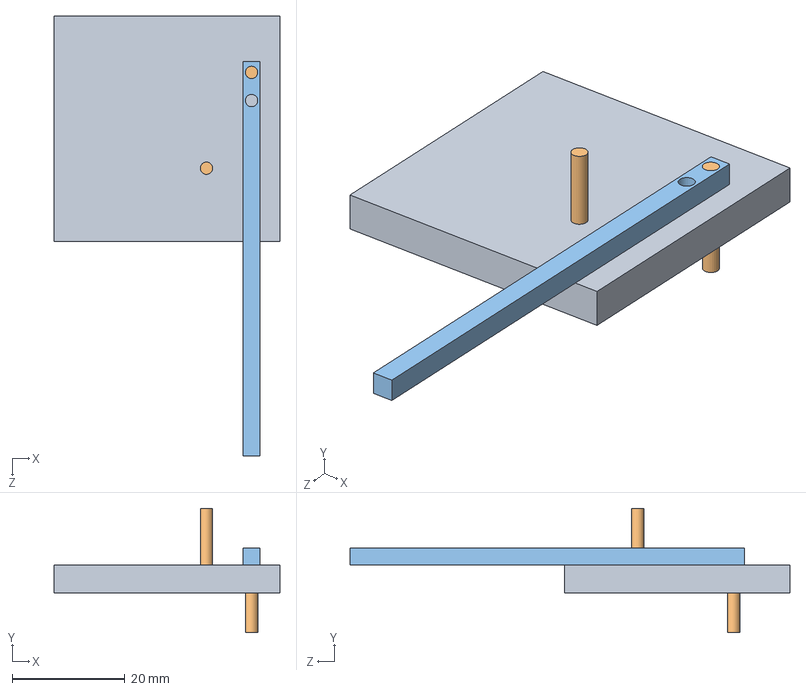
[picture p32: CAD file, 2017-03-06]
Cargo Acquisition/HookAssembly.SLDASM
40.0 x 22.0 x 78.0 mm
Chassis Base
15mm_Pin x 2
HOOK
