ibro-rox/D4-Ganges/Cargo Acquisition/cargo cam.DXF

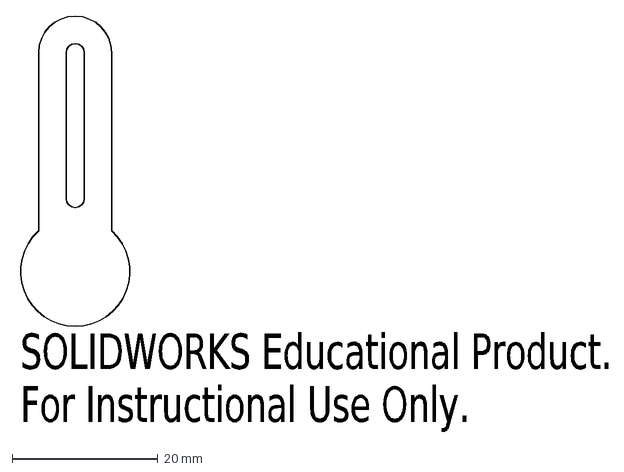
[picture p33: CAD file, 2017-03-08]
Cargo Acquisition/cargo cam.DXF
SOLIDWORKS Educational Product.
For Instructional Use Only.
