ibro-rox/D4-Ganges/ChassisDesign/Laser_cutting_design_4.dxf

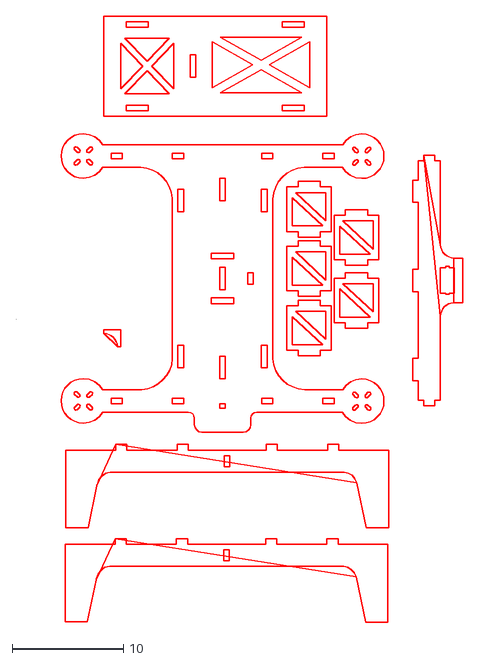
[picture p34: CAD file, 2017-03-08]
ChassisDesign/Laser_cutting_design_4.dxf
40.1 x 54.4
