ibro-rox/D4-Ganges/Cargo Acquisition/ServoCam.SLDPRT

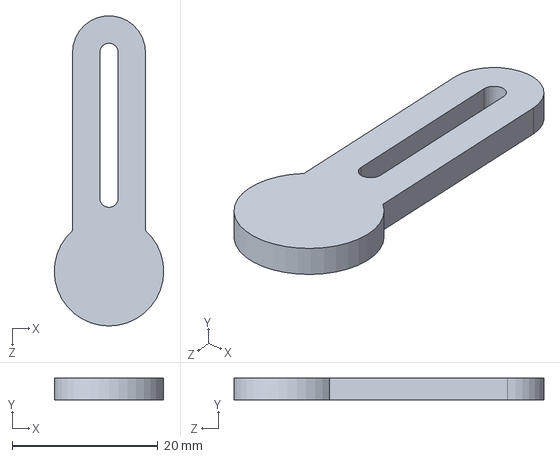
[picture p35: CAD file, 2017-03-07]
Cargo Acquisition/ServoCam.SLDPRT
15.0 x 3.00 x 42.5 mm
