ibro-rox/D4-Ganges/ChassisDesign/Laser_cutting_design_4_1.dxf

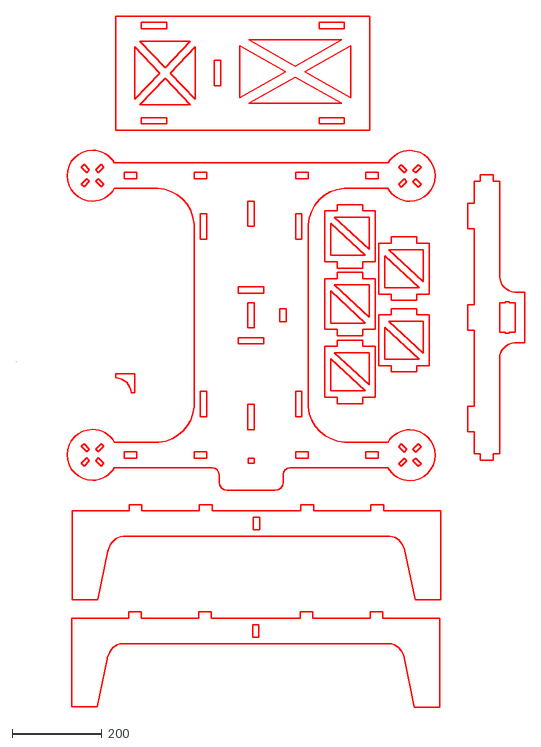
[picture p36: CAD file, 2017-03-08]
ChassisDesign/Laser_cutting_design_4_1.dxf
1136.3 x 1543.2
