ibro-rox/D4-Ganges/Cargo Acquisition/Chassis Base.SLDPRT

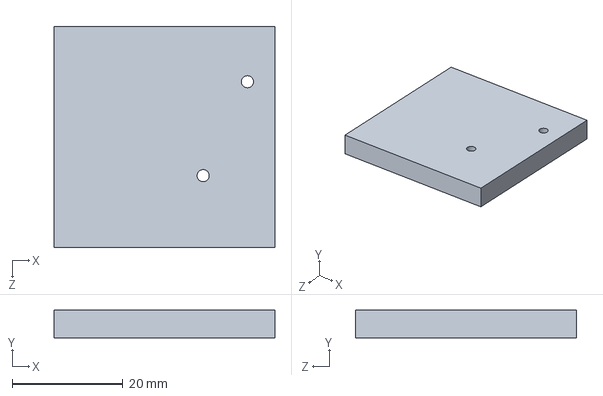
[picture p37: CAD file, 2017-03-06]
Cargo Acquisition/Chassis Base.SLDPRT
40.0 x 5.00 x 40.0 mm
