ibro-rox/D4-Ganges/Cargo Acquisition/15mm_Pin.SLDPRT

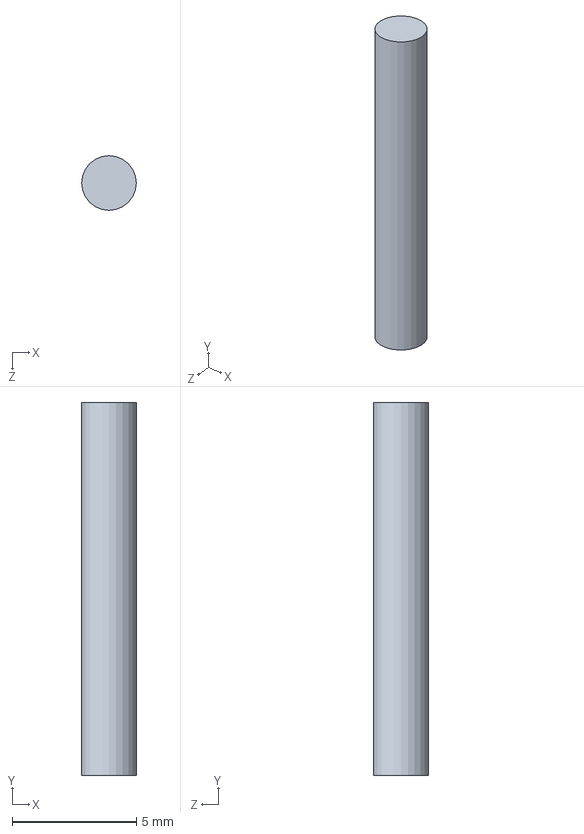
[picture p38: CAD file, 2017-03-06]
Cargo Acquisition/15mm_Pin.SLDPRT
2.20 x 15.0 x 2.20 mm
