ibro-rox/D4-Ganges/Cargo Acquisition/HOOK.SLDPRT

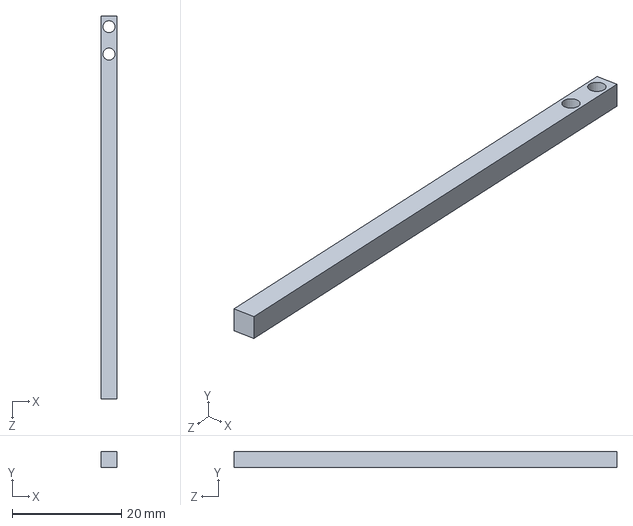
[picture p39: CAD file, 2017-03-06]
Cargo Acquisition/HOOK.SLDPRT
3.00 x 3.00 x 70.0 mm
