ibro-rox/D4-Ganges/(list of files, cad)

Other CAD files:
Cargo Acquisition/ServoCam.DWG
Cargo Acquisition/ServoCam.DXF
Cargo Acquisition/ServoCam.SLDDRW
