ibro-rox/D4-Ganges/ChassisDesign/print2_2802.pdf

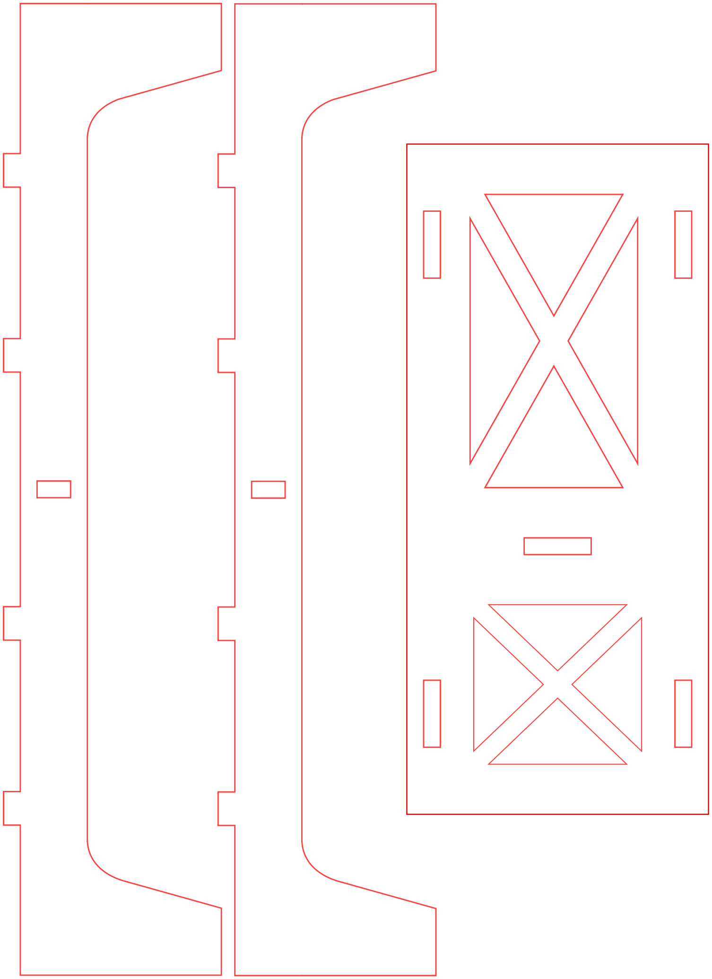
[picture p40: figure]
