ibro-rox/D4-Ganges/(threads)

Thread 3 (2017-02-26):

ESC PWM resolution

ljg2305, 2017-02-26:
we seem to have only 13 bits to play with when it come to the active part of the pwm, this means only 13 levels of motor power from off to max speed.

jh16g15, 2017-02-27:
Switched to Arduino Leonardo (ATMEGA32u4) with enough 16-bit timers to use for the motor PWM.

Closed 2017-02-27.

Thread 5 (2017-02-28):

MPU6050 stop use of interrupts

jh16g15, 2017-02-28:
At present, the test program uses the 'data ready' interrupt from the MPU6050 to collect new data. At present, the MPU6050 DMP (Digital Motion Processor) has new data ready about 100 times per second - as the control loop is unlikely to need this much data, the time spent in the ISR each time is potentially wasted.

jh16g15, 2017-03-06:
This is no longer necessary as the MPU6050 DMP will only run at frequencies of 200/1+val, and so as the control algorithm and internal comms should be fast enough to use all the data the time in the ISR is not wasted

Closed 2017-03-06.
