ibro-rox/D4-Ganges/Schematic/onboard_v1.0.pdf

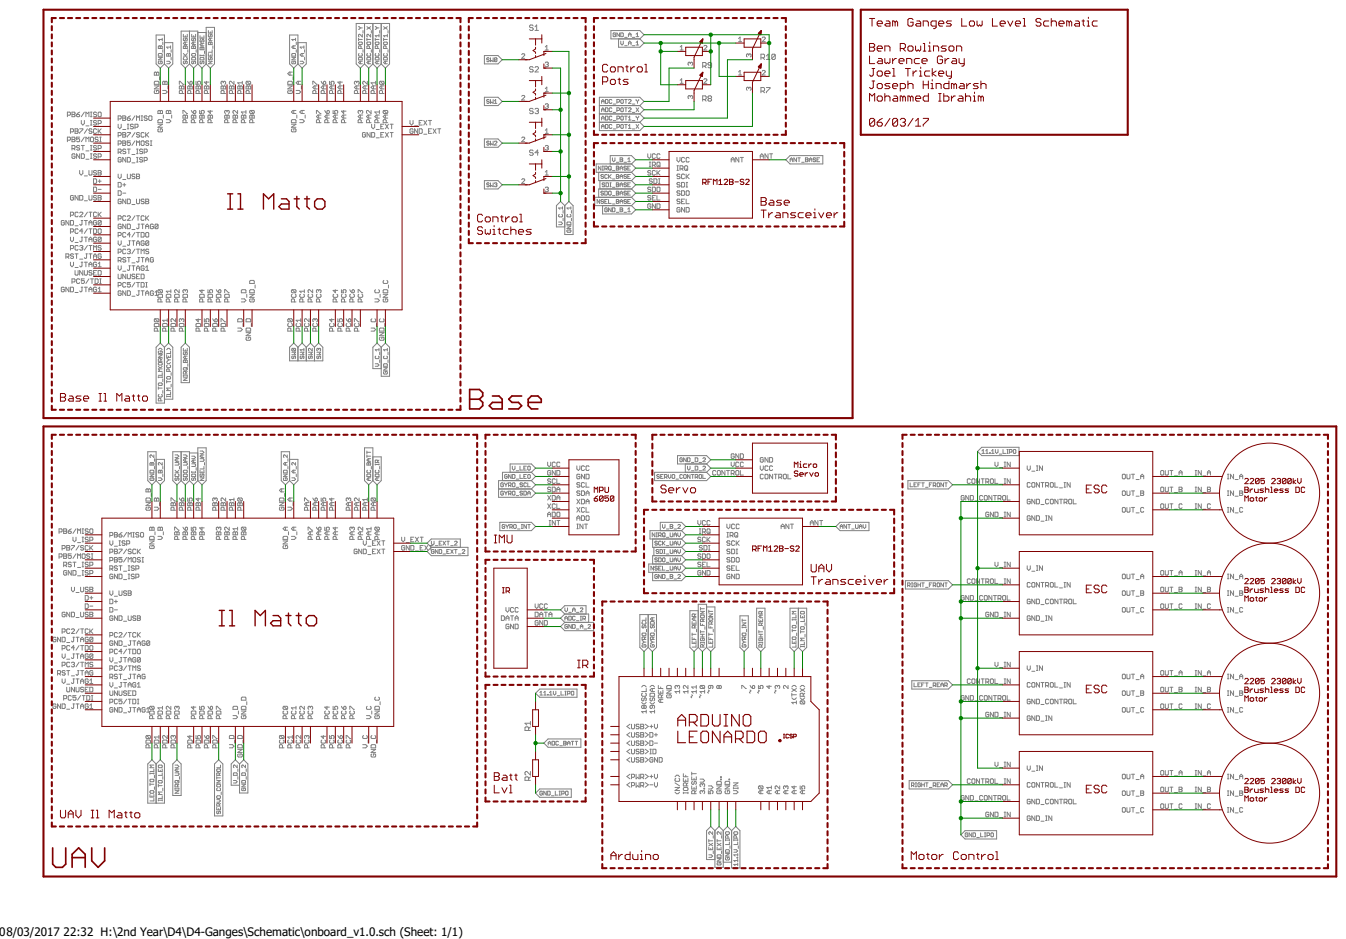
[picture p41: page 1]

08/03/2017 22:32 H:\2nd Year\D4\D4-Ganges\Schematic\onboard_v1.0.sch (Sheet: 1/1)
