ibro-rox/D4-Ganges/Admin/D4 - Ganges High Level Block Schematic_4.pdf

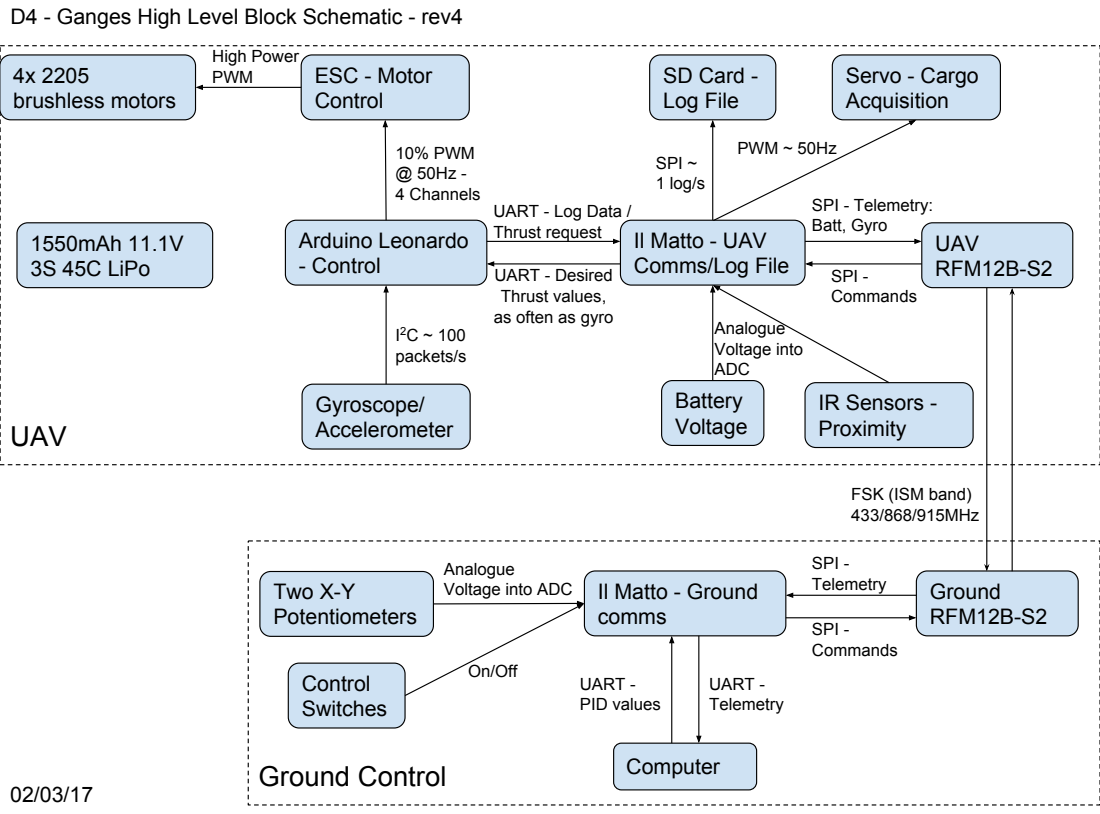
[picture p42: page 1]
Two X-Y Potentiometers; Ground RFM12B-S2; Computer; UAV RFM12B-S2; Arduino Leonardo - Control; SD Card - Log File; Servo - Cargo Acquisition; IR Sensors - Proximity; ESC - Motor Control; Gyroscope/ Accelerometer; 4x 2205 brushless motors; High Power PWM; 10% PWM @ 50Hz - 4 Channels; 2C ~ 100 packets/s; SPI ~ 1 log/s; PWM ~ 50Hz; SPI - Telemetry: Batt, Gyro; SPI - Commands; Analogue Voltage into ADC; SPI - Telemetry; UART - PID values; UART - Telemetry; UAV; Ground Control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

D4 - Ganges High Level Block Schematic - rev4

UART - Log Data /
Thrust request

Il Matto - UAV
Comms/Log File

UART - Desired
Thrust values,
as often as gyro

FSK (ISM band)
433/868/915MHz

Analogue
Voltage into ADC

Il Matto - Ground
comms
