ibro-rox/D4-Ganges/Admin/final_report/BlockDiagram.pdf

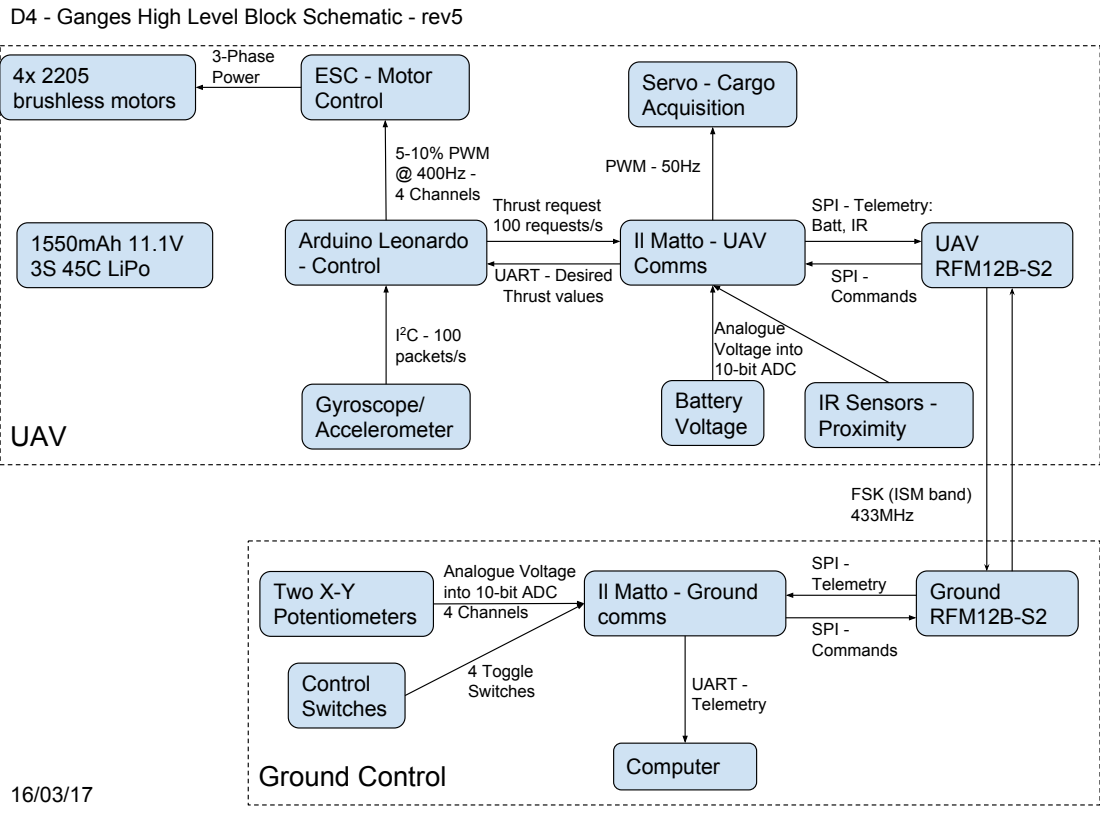
[picture p43: page 1]
Two X-Y Potentiometers; Ground RFM12B-S2; Computer; UAV RFM12B-S2; Arduino Leonardo - Control; Servo - Cargo Acquisition; IR Sensors - Proximity; ESC - Motor Control; Gyroscope/ Accelerometer; 4x 2205 brushless motors; 3-Phase Power; 5-10% PWM @ 400Hz - 4 Channels; 2C - 100 packets/s; Thrust request 100 requests/s; UART - Desired Thrust values; PWM - 50Hz; SPI - Telemetry: Batt, IR; SPI - Commands; Analogue Voltage into 10-bit ADC; SPI - Telemetry; UART - Telemetry; UAV; Ground Control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

D4 - Ganges High Level Block Schematic - rev5

Il Matto - UAV
Comms

FSK (ISM band)
433MHz

Analogue Voltage
into 10-bit ADC
4 Channels

Il Matto - Ground
comms
