ibro-rox/D4-Ganges/ChassisDesign/print1_2802.pdf

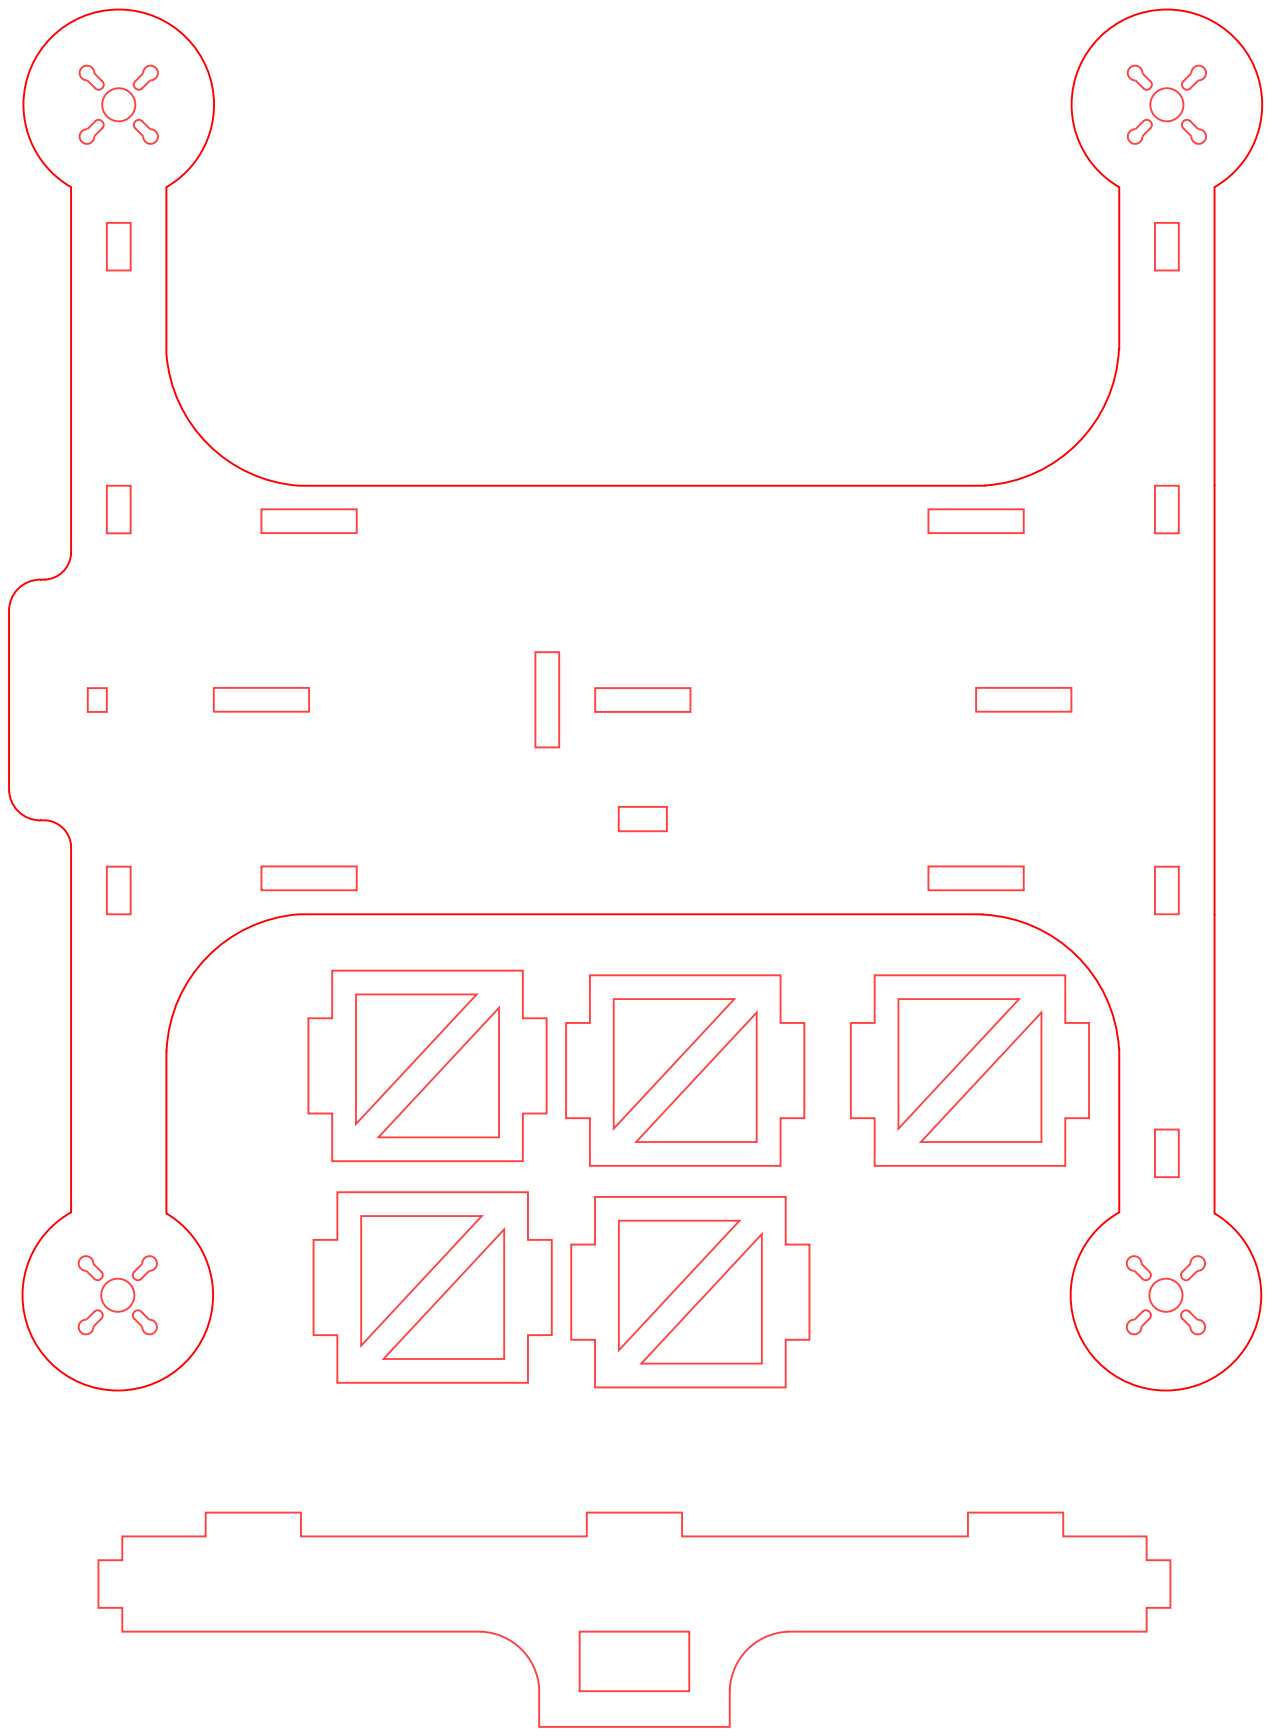
[picture p44: page 1]
