ibro-rox/D4-Ganges/Admin/D4 - Ganges High Level Block Schematic_3.pdf

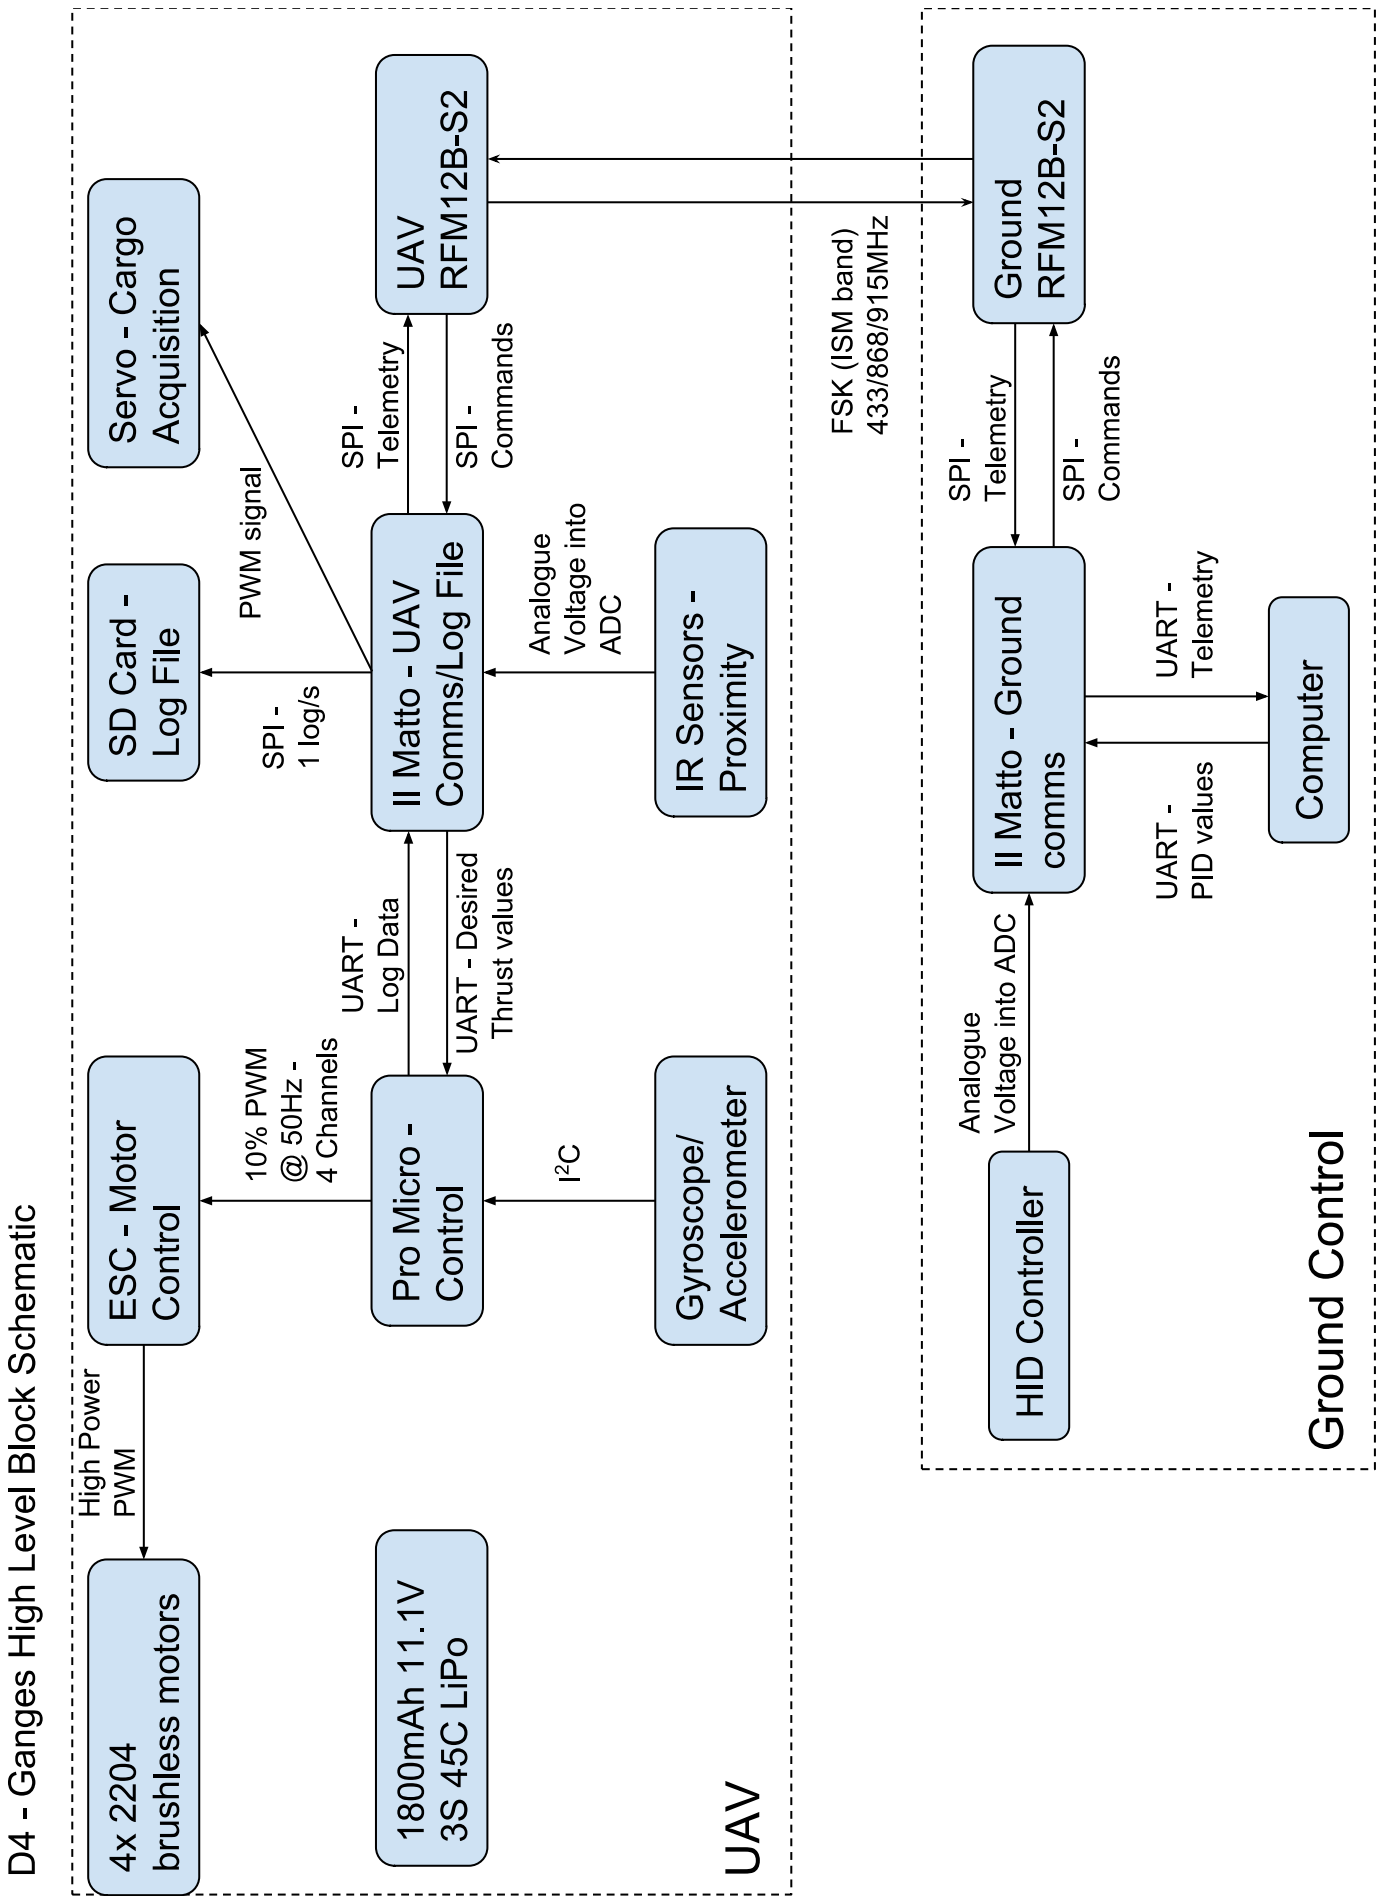
[picture p45: page 1]
