ibro-rox/D4-Ganges/ChassisDesign/print1.pdf

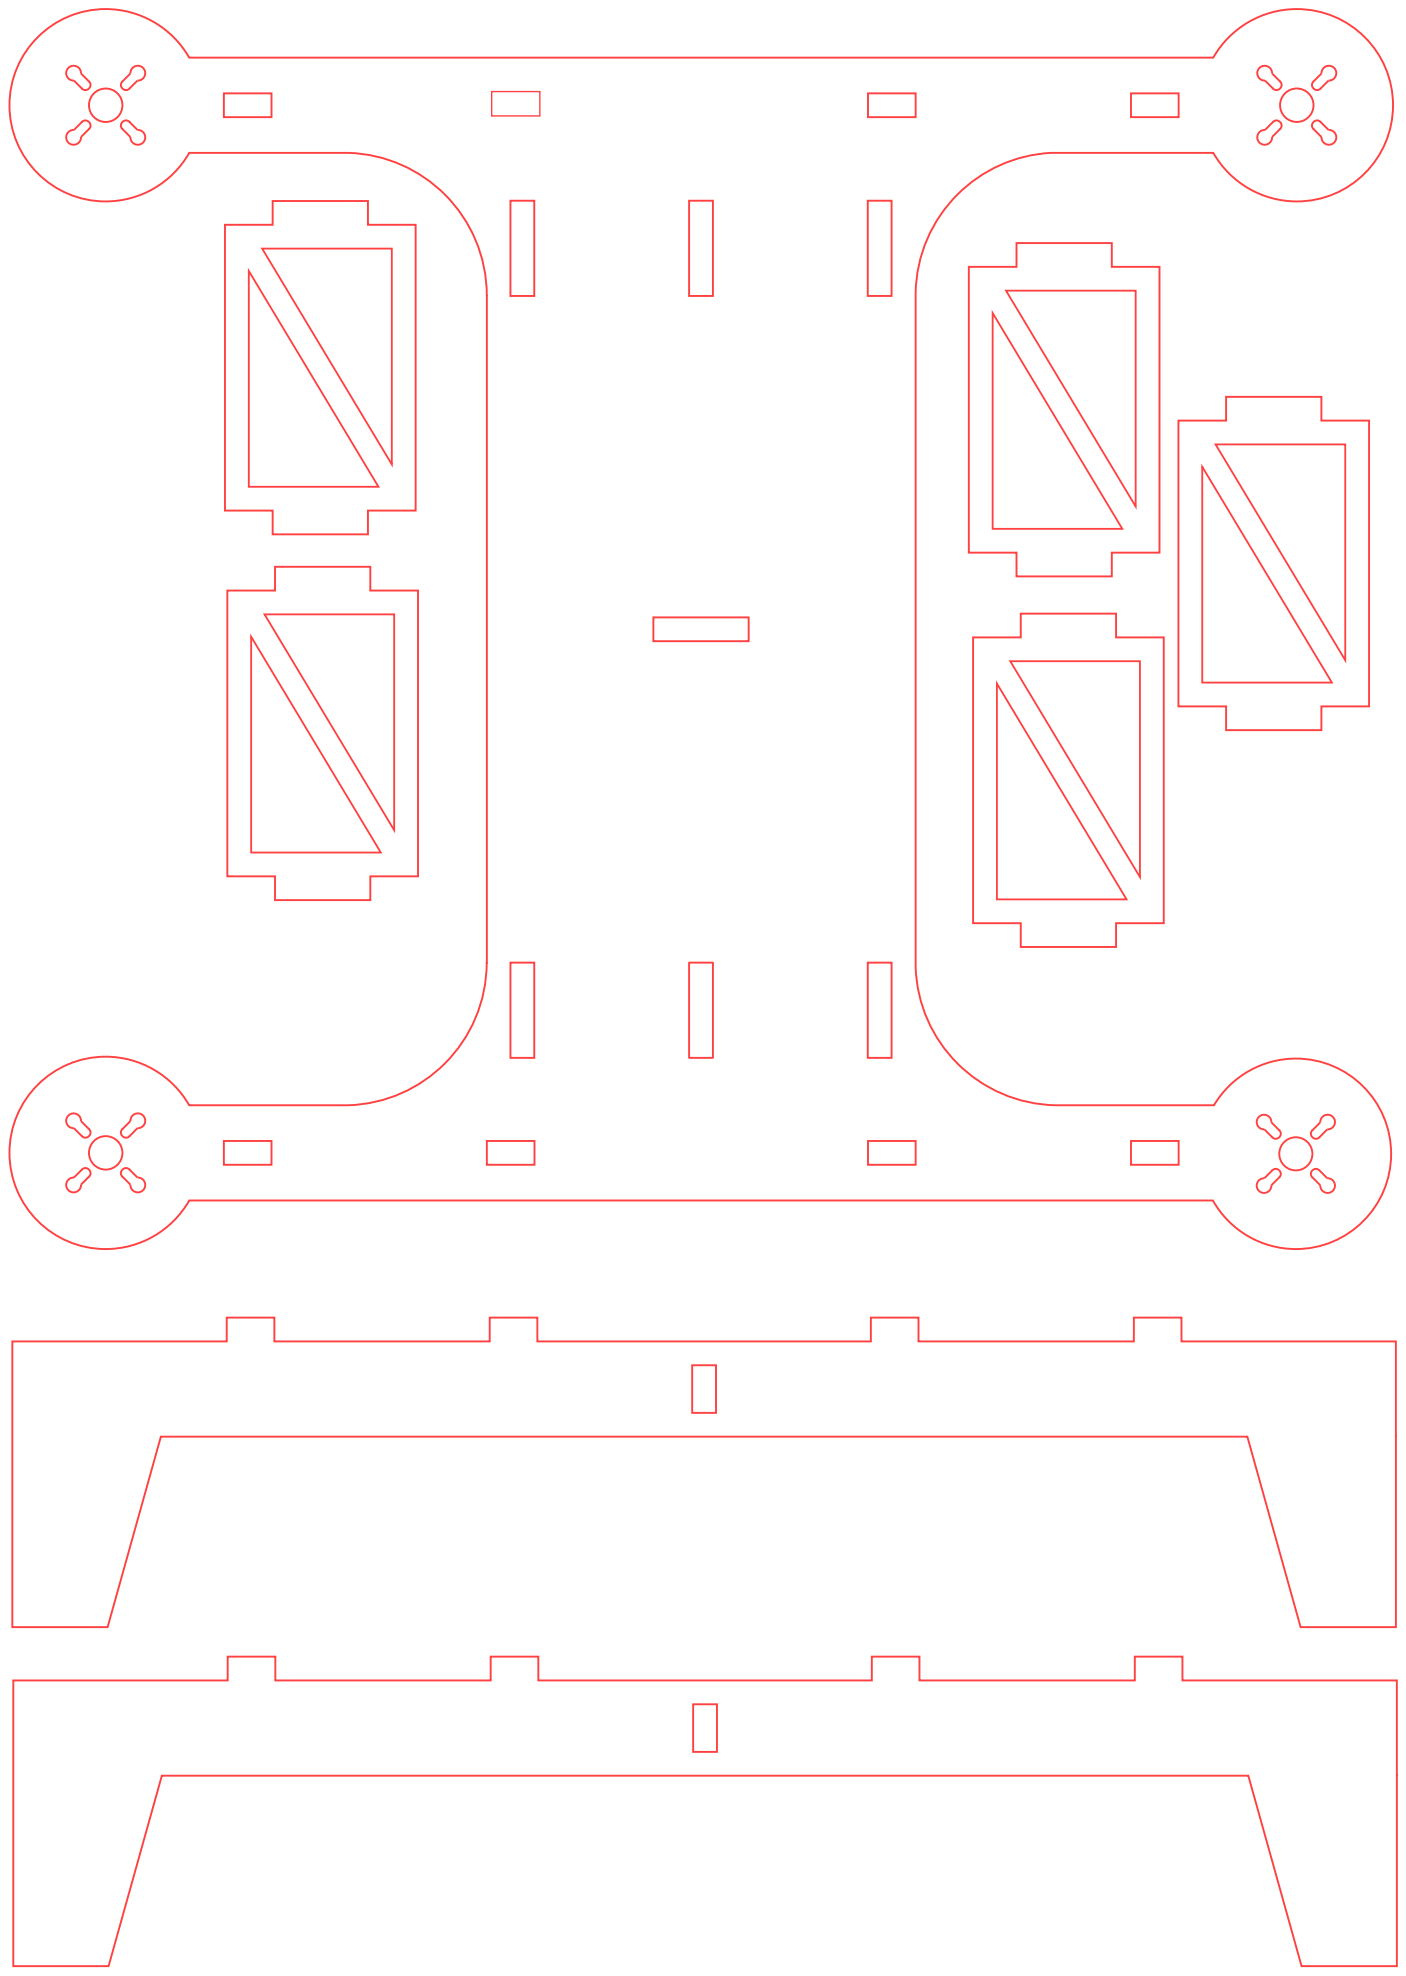
[picture p46: page 1]
