ibro-rox/D4-Ganges/ChassisDesign/Controller/draft1.pdf

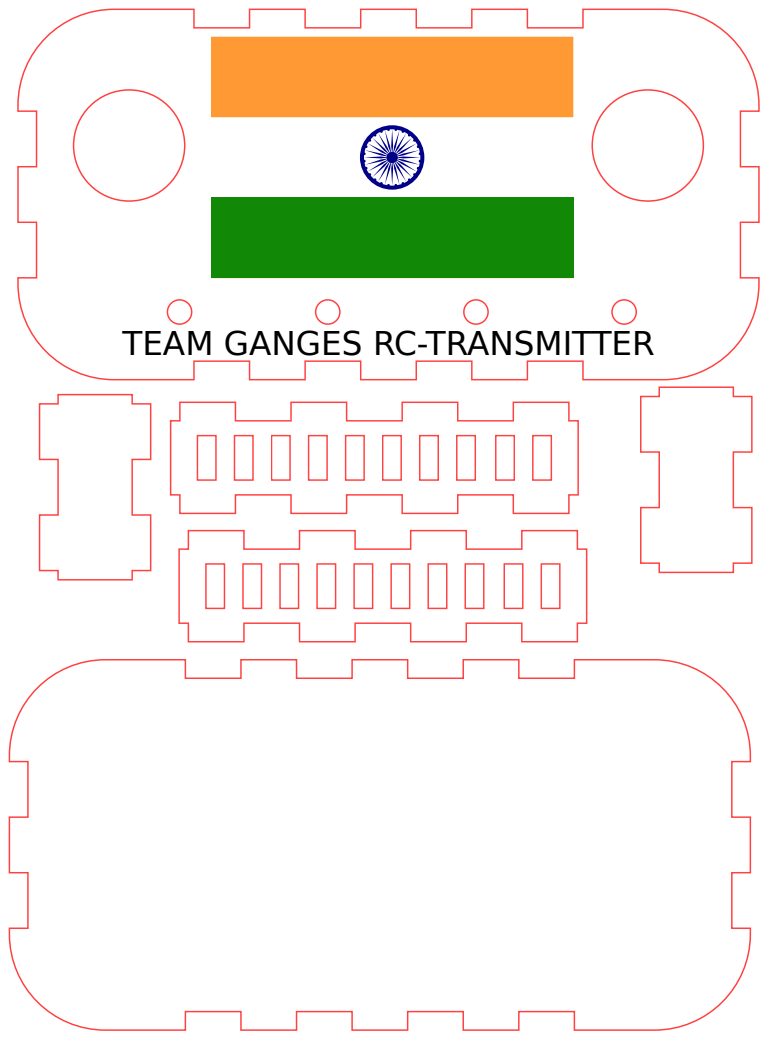
[picture p47: page 1]

TEAM GANGES RC-TRANSMITTER
