ibro-rox/D4-Ganges/Cargo Acquisition/ServoCam.PDF

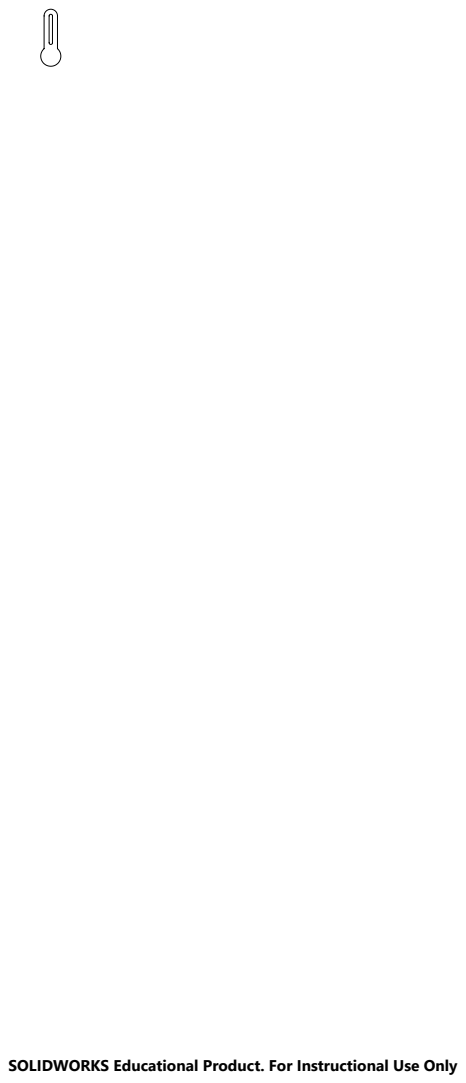
[picture p48: page 1]

SOLIDWORKS Educational Product. For Instructional Use Only
