ibro-rox/D4-Ganges/Schematic/onboard_v1.1.sch

## EAGLE design Schematic/onboard_v1.1.sch (2017-03-16)

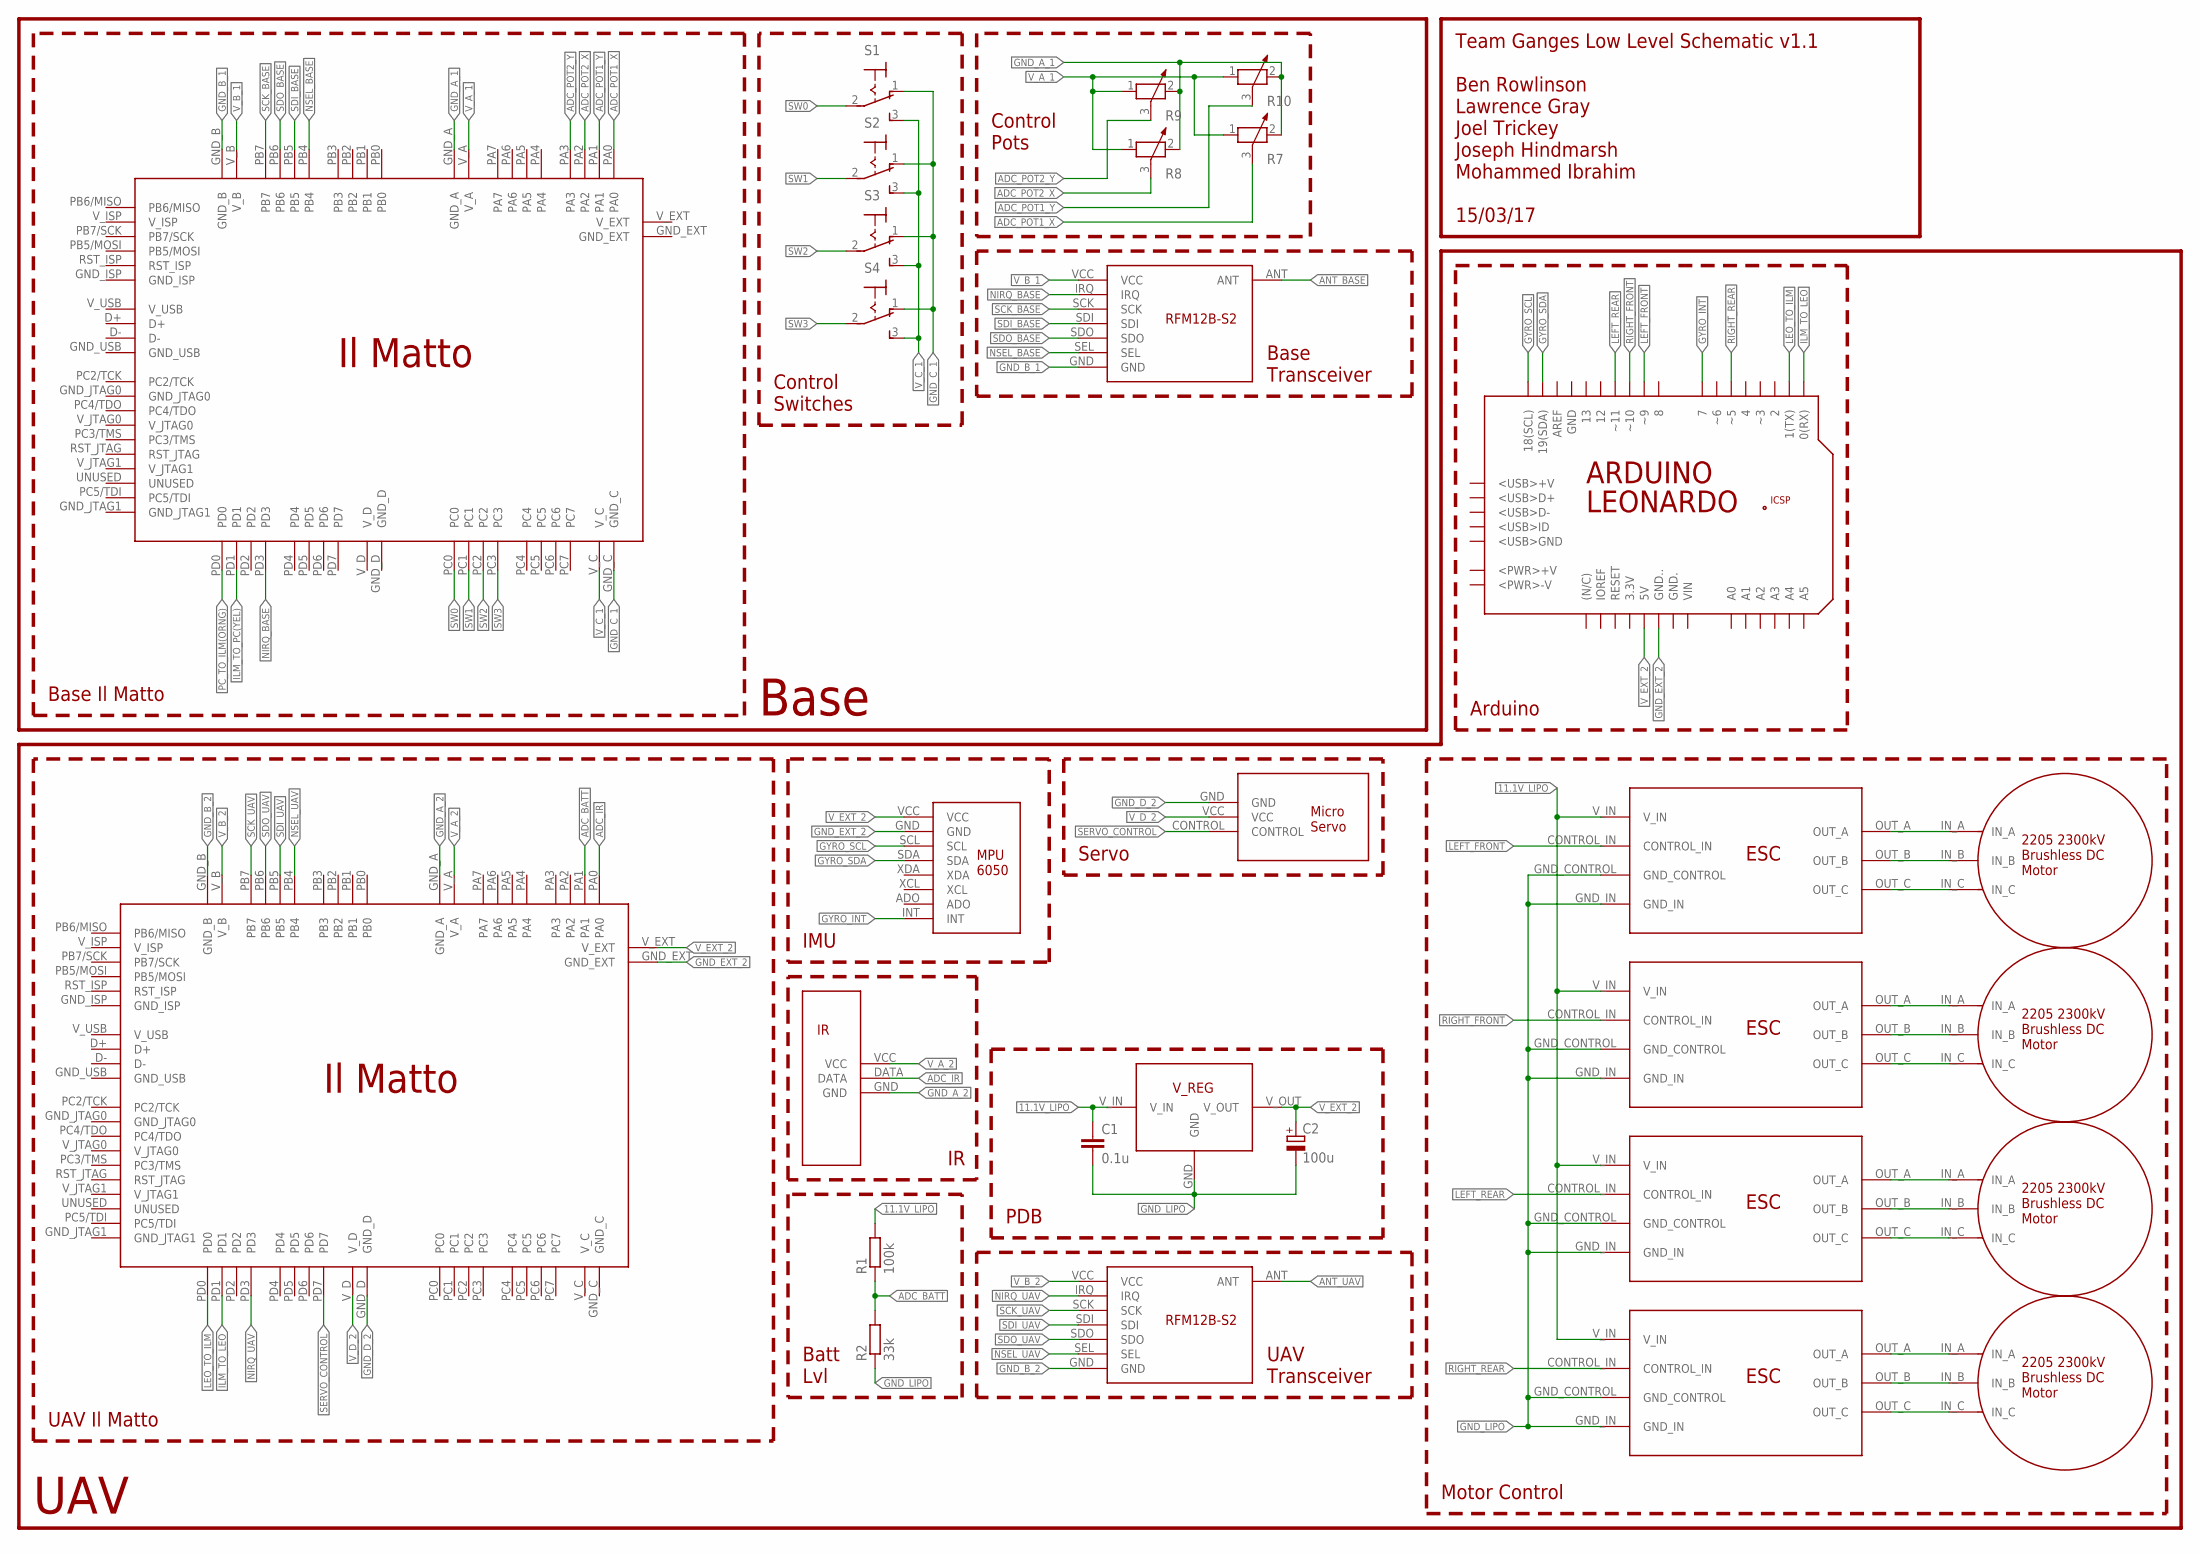
[picture p49: schematic onboard_v1.1.sch]

Parts:
C1: 0.1u; C025-024X044
C2: 100u; B45181C
LEFT_FRONT_ESC: ESC
LEFT_FRONT_MOTOR: MOTOR
LEFT_REAR_ESC: ESC
LEFT_REAR_MOTOR: MOTOR
R1: 100k; 0204/7
R2: 33k; 0204/7
R7, R8, R9, R10: POTENTIOMETER_PT-10; PT-10
RIGHT_FRONT_ESC: ESC
RIGHT_FRONT_MOTOR: MOTOR
RIGHT_REAR_ESC: ESC
RIGHT_REAR_MOTOR: MOTOR
S1, S2, S3, S4: 320-916
U$1, U$16: IL-MATTO
U$2: V_REG
U$3: MPU6050
U$4: IR_SENSOR
U$5, U$14: RFM12B-S2
U$6: MICRO_SERVO

Connections:
11.1V_LIPO: C1.1, LEFT_FRONT_ESC.V_IN, LEFT_REAR_ESC.V_IN, R1.2, RIGHT_FRONT_ESC.V_IN, RIGHT_REAR_ESC.V_IN, U$2.V_IN
ADC_BATT: R1.1, R2.2, U$1.PA1
ADC_IR: U$1.PA0, U$4.DATA
ADC_POT1_X: R7.3, U$16.PA0
ADC_POT1_Y: R10.3, U$16.PA1
ADC_POT2_X: R8.3, U$16.PA2
ADC_POT2_Y: R9.3, U$16.PA3
ANT_BASE: U$14.ANT
ANT_UAV: U$5.ANT
GND_A_1: R7.2, R8.2, R9.2, R10.2, U$16.GND_A
GND_A_2: U$1.GND_A, U$4.GND
GND_B_1: U$14.GND, U$16.GND_B
GND_B_2: U$1.GND_B, U$5.GND
GND_C_1: S1.1 (O), S2.1 (O), S3.1 (O), S4.1 (O), U$16.GND_C
GND_D_2: U$1.GND_D, U$6.GND
GND_EXT_2: U$1.GND_EXT, U$3.GND
GND_LIPO: C1.2, C2.-, LEFT_FRONT_ESC.GND_CONTROL, LEFT_FRONT_ESC.GND_IN, LEFT_REAR_ESC.GND_CONTROL, LEFT_REAR_ESC.GND_IN, R2.1, RIGHT_FRONT_ESC.GND_CONTROL, RIGHT_FRONT_ESC.GND_IN, RIGHT_REAR_ESC.GND_CONTROL, RIGHT_REAR_ESC.GND_IN, U$2.GND
GYRO_INT: U$3.INT
GYRO_SCL: U$3.SCL
GYRO_SDA: U$3.SDA
ILM_TO_LEO: U$1.PD1
ILM_TO_PC(YEL): U$16.PD1
LEFT_FRONT: LEFT_FRONT_ESC.CONTROL_IN
LEFT_REAR: LEFT_REAR_ESC.CONTROL_IN
LEO_TO_ILM: U$1.PD0
unnamed: LEFT_FRONT_ESC.OUT_A, LEFT_FRONT_MOTOR.IN_A
unnamed: LEFT_FRONT_ESC.OUT_B, LEFT_FRONT_MOTOR.IN_B
unnamed: LEFT_FRONT_ESC.OUT_C, LEFT_FRONT_MOTOR.IN_C
unnamed: RIGHT_FRONT_ESC.OUT_A, RIGHT_FRONT_MOTOR.IN_A
unnamed: RIGHT_FRONT_ESC.OUT_B, RIGHT_FRONT_MOTOR.IN_B
unnamed: RIGHT_FRONT_ESC.OUT_C, RIGHT_FRONT_MOTOR.IN_C
unnamed: LEFT_REAR_ESC.OUT_A, LEFT_REAR_MOTOR.IN_A
unnamed: LEFT_REAR_ESC.OUT_B, LEFT_REAR_MOTOR.IN_B
unnamed: LEFT_REAR_ESC.OUT_C, LEFT_REAR_MOTOR.IN_C
unnamed: RIGHT_REAR_ESC.OUT_A, RIGHT_REAR_MOTOR.IN_A
unnamed: RIGHT_REAR_ESC.OUT_B, RIGHT_REAR_MOTOR.IN_B
unnamed: RIGHT_REAR_ESC.OUT_C, RIGHT_REAR_MOTOR.IN_C
NIRQ_BASE: U$14.IRQ, U$16.PD3
NIRQ_UAV: U$1.PD3, U$5.IRQ
NSEL_BASE: U$14.SEL, U$16.PB4
NSEL_UAV: U$1.PB4, U$5.SEL
PC_TO_ILM(ORNG): U$16.PD0
RIGHT_FRONT: RIGHT_FRONT_ESC.CONTROL_IN
RIGHT_REAR: RIGHT_REAR_ESC.CONTROL_IN
SCK_BASE: U$14.SCK, U$16.PB7
SCK_UAV: U$1.PB7, U$5.SCK
SDI_BASE: U$14.SDI, U$16.PB5
SDI_UAV: U$1.PB5, U$5.SDI
SDO_BASE: U$14.SDO, U$16.PB6
SDO_UAV: U$1.PB6, U$5.SDO
SERVO_CONTROL: U$1.PD7, U$6.CONTROL
SW0: S1.2, U$16.PC0
SW1: S2.2, U$16.PC1
SW2: S3.2, U$16.PC2
SW3: S4.2, U$16.PC3
V_A_1: R7.1, R8.1, R9.1, R10.1, U$16.V_A
V_A_2: U$1.V_A, U$4.VCC
V_B_1: U$14.VCC, U$16.V_B
V_B_2: U$1.V_B, U$5.VCC
V_C_1: S1.3 (S), S2.3 (S), S3.3 (S), S4.3 (S), U$16.V_C
V_D_2: U$1.V_D, U$6.VCC
V_EXT_2: C2.+, U$1.V_EXT, U$2.V_OUT, U$3.VCC

Notes on the sheet:
Servo
UAV Transceiver
Batt Lvl
IMU
Arduino
Motor Control
UAV Il Matto
Base Il Matto
Base Transceiver
Control Switches
Control Pots
Base
UAV
Team Ganges Low Level Schematic v1.1
Ben Rowlinson Lawrence Gray Joel Trickey Joseph Hindmarsh Mohammed Ibrahim
15/03/17
PDB
