ibro-rox/D4-Ganges/ControlIntegration/ESCPID/AccelGyro/AccelGyro.ino

// I2C device class (I2Cdev) demonstration Arduino sketch for MPU6050 class using DMP (MotionApps v2.0)
// 6/21/2012 by Jeff Rowberg <jeff@rowberg.net>
// Updates should (hopefully) always be available at https://github.com/jrowberg/i2cdevlib
//
// Changelog:
//      2013-05-08 - added seamless Fastwire support
//                 - added note about gyro calibration
//      2012-06-21 - added note about Arduino 1.0.1 + Leonardo compatibility error
//      2012-06-20 - improved FIFO overflow handling and simplified read process
//      2012-06-19 - completely rearranged DMP initialization code and simplification
//      2012-06-13 - pull gyro and accel data from FIFO packet instead of reading directly
//      2012-06-09 - fix broken FIFO read sequence and change interrupt detection to RISING
//      2012-06-05 - add gravity-compensated initial reference frame acceleration output
//                 - add 3D math helper file to DMP6 example sketch
//                 - add Euler output and Yaw/Pitch/Roll output formats
//      2012-06-04 - remove accel offset clearing for better results (thanks Sungon Lee)
//      2012-06-01 - fixed gyro sensitivity to be 2000 deg/sec instead of 250
//      2012-05-30 - basic DMP initialization working

/* ============================================
I2Cdev device library code is placed under the MIT license
Copyright (c) 2012 Jeff Rowberg

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
THE SOFTWARE IS PROVIDED "AS IS", WITHOUT WARRANTY OF ANY KIND, EXPRESS OR
IMPLIED, INCLUDING BUT NOT LIMITED TO THE WARRANTIES OF MERCHANTABILITY,
FITNESS FOR A PARTICULAR PURPOSE AND NONINFRINGEMENT. IN NO EVENT SHALL THE
AUTHORS OR COPYRIGHT HOLDERS BE LIABLE FOR ANY CLAIM, DAMAGES OR OTHER
LIABILITY, WHETHER IN AN ACTION OF CONTRACT, TORT OR OTHERWISE, ARISING FROM,
OUT OF OR IN CONNECTION WITH THE SOFTWARE OR THE USE OR OTHER DEALINGS IN
THE SOFTWARE.
===============================================
*/

// I2Cdev and MPU6050 must be installed as libraries, or else the .cpp/.h files
// for both classes must be in the include path of your project
#include "I2Cdev.h"


//Lawrence
#include "PWM.h"
#include "PID.h"
#include "utils.h"

#include "MPU6050_6Axis_MotionApps20.h"
//#include "MPU6050.h" // not necessary if using MotionApps include file

// Arduino Wire library is required if I2Cdev I2CDEV_ARDUINO_WIRE implementation
// is used in I2Cdev.h
#if I2CDEV_IMPLEMENTATION == I2CDEV_ARDUINO_WIRE
    #include "Wire.h"
#endif

// class default I2C address is 0x68
// specific I2C addresses may be passed as a parameter here
// AD0 low = 0x68 (default for SparkFun breakout and InvenSense evaluation board)
// AD0 high = 0x69
MPU6050 mpu;
PID yawPID(0,0,0);
PID pitchPID(0.4,1e-5,18);
//PID pitchPID(0.4,1e-5,18);
//PID pitchPID(0.1,0.002,10);
//PID rollPID(0.4,1e-5,18);
PID rollPID(0.4,2e-5,18);
//MPU6050 mpu(0x69); // <-- use for AD0 high

/* =========================================================================
   NOTE: In addition to connection 3.3v, GND, SDA, and SCL, this sketch
   depends on the MPU-6050's INT pin being connected to the Arduino's
   external interrupt #0 pin. On the Arduino Uno and Mega 2560, this is
   digital I/O pin 2.
 * ========================================================================= */

/* =========================================================================
   NOTE: Arduino v1.0.1 with the Leonardo board generates a compile error
   when using Serial.write(buf, len). The Teapot output uses this method.
   The solution requires a modification to the Arduino USBAPI.h file, which
   is fortunately simple, but annoying. This will be fixed in the next IDE
   release. For more info, see these links:

   http://arduino.cc/forum/index.php/topic,109987.0.html
   http://code.google.com/p/arduino/issues/detail?id=958
 * ========================================================================= */


// ================================================================
// ===                CONFIG AND SETUP                          ===
// ================================================================

//uncomment this for debugging and to test data collection
//#define SERIAL_ENABLED


// uncomment "OUTPUT_READABLE_YAWPITCHROLL" if you want to see the yaw/
// pitch/roll angles (in degrees) calculated from the quaternions coming
// from the FIFO. Note this also requires gravity vector calculations.
// Also note that yaw/pitch/roll angles suffer from gimbal lock (for
// more info, see: http://en.wikipedia.org/wiki/Gimbal_lock)
#define OUTPUT_READABLE_YAWPITCHROLL

// uncomment "OUTPUT_READABLE_REALACCEL" if you want to see acceleration
// components with gravity removed. This acceleration reference frame is
// not compensated for orientation, so +X is always +X according to the
// sensor, just without the effects of gravity. If you want acceleration
// compensated for orientation, us OUTPUT_READABLE_WORLDACCEL instead.
//#define OUTPUT_READABLE_REALACCEL

// uncomment "OUTPUT_READABLE_WORLDACCEL" if you want to see acceleration
// components with gravity removed and adjusted for the world frame of
// reference (yaw is relative to initial orientation, since no magnetometer
// is present in this case). Could be quite handy in some cases.
//#define OUTPUT_READABLE_WORLDACCEL

unsigned long delta_time=0;
unsigned long previous_time=0;
unsigned long time_elapsed=0;

bool blinkState = false;

// MPU control/status vars
bool dmpReady = false;  // set true if DMP init was successful
uint8_t mpuIntStatus;   // holds actual interrupt status byte from MPU
uint8_t devStatus;      // return status after each device operation (0 = success, !0 = error)
uint16_t packetSize;    // expected DMP packet size (default is 42 bytes)
uint16_t fifoCount;     // count of all bytes currently in FIFO
uint8_t fifoBuffer[64]; // FIFO storage buffer

// orientation/motion vars
Quaternion q;           // [w, x, y, z]         quaternion container
VectorInt16 aa;         // [x, y, z]            accel sensor measurements
VectorInt16 aaReal;     // [x, y, z]            gravity-free accel sensor measurements
VectorInt16 aaWorld;    // [x, y, z]            world-frame accel sensor measurements
VectorFloat gravity;    // [x, y, z]            gravity vector

float ypr[3];           // [yaw, pitch, roll]   yaw/pitch/roll container and gravity vector

//controller values
float throttle;
float targetYaw;
float targetPitch;
float targetRoll;
//gyro values
float gyroYaw = 0;   //initalising to zero for rate of change
float gyroYawPrev = 0;
float gyroPitch;
float gyroRoll;
//PID output values
float pidYaw;
float pidPitch;
float pidRoll;

// ================================================================
// ===          VALUES FOR SERIAL COMMS WITH IL-MATTO           ===
// ================================================================


String throttleString = "";         // a string to hold incoming data
String yawString      = ""; 
String pitchString      = ""; 
String rollString      = ""; 
int throttleInput = 0;
int yawInput = 0;
int pitchInput = 0;
int rollInput = 0;

boolean stringComplete = false;  // whether the string is complete
char packetFlag;

void pulse(void);
void serialEvent(void);
void printInt(void);

// ================================================================
// ===               INTERRUPT DETECTION ROUTINE                ===
// ================================================================


volatile bool mpuInterrupt = false;     // indicates whether MPU interrupt pin has gone high
void dmpDataReady() {
    mpuInterrupt = true;
}



// ================================================================
// ===                      INITIAL SETUP                       ===
// ================================================================

void setup() {
    pinMode(LED_PIN, OUTPUT);    // configure LED for output
    digitalWrite(LED_PIN, HIGH);
  
    delay(1000);  //delay to allow ESCs to boot up

    digitalWrite(LED_PIN, LOW);
    // join I2C bus (I2Cdev library doesn't do this automatically)
    #if I2CDEV_IMPLEMENTATION == I2CDEV_ARDUINO_WIRE
        Wire.begin();
        Wire.setClock(400000); // 400kHz I2C clock. Comment this line if having compilation difficulties
    #elif I2CDEV_IMPLEMENTATION == I2CDEV_BUILTIN_FASTWIRE
        Fastwire::setup(400, true);
    #endif

    #ifdef SERIAL_ENABLED
    // initialize serial communication
    // (115200 chosen because it is required for Teapot Demo output, but it's
    // really up to you depending on your project)
    Serial.begin(115200);
    while (!Serial); // wait for Leonardo enumeration, others continue immediately

    // NOTE: 8MHz or slower host processors, like the Teensy @ 3.3v or Ardunio
    // Pro Mini running at 3.3v, cannot handle this baud rate reliably due to
    // the baud timing being too misaligned with processor ticks. You must use
    // 38400 or slower in these cases, or use some kind of external separate
    // crystal solution for the UART timer.

    // initialize device
    Serial.println(F("Initializing I2C devices..."));
    #endif
    
    mpu.initialize();


    
    pinMode(GYRO_INTERRUPT, INPUT);   //interrupt for gyro setup
    
    // verify connection
    #ifdef SERIAL_ENABLED
    Serial.println(F("Testing device connections..."));
    Serial.println(mpu.testConnection() ? F("MPU6050 connection successful") : F("MPU6050 connection failed"));

    // wait for ready
    //Serial.println(F("\nSend any character to begin DMP programming and demo: "));
    while (Serial.available() && Serial.read()); // empty buffer
    /*while (!Serial.available());                 // wait for data
    while (Serial.available() && Serial.read()); // empty buffer again*/

    // load and configure the DMP
    Serial.println(F("Initializing DMP..."));
    #endif
    
    devStatus = mpu.dmpInitialize();

    // supply your own gyro offsets here, scaled for min sensitivity
    mpu.setXGyroOffset(37);
    mpu.setYGyroOffset(21);
    //mpu.setYGyroOffset(20);
    mpu.setZGyroOffset(-4);
    mpu.setZAccelOffset(1545); // 1688 factory default for my test chip
    mpu.setYAccelOffset(2627);
    mpu.setXAccelOffset(1632);

    // make sure it worked (returns 0 if so)
    if (devStatus == 0) {
        // turn on the DMP, now that it's ready
        //Serial.println(F("Enabling DMP..."));
        mpu.setDMPEnabled(true);

        // enable Arduino interrupt detection
        #ifdef SERIAL_ENABLED
        Serial.println(F("Enabling interrupt detection (Arduino external interrupt 0)..."));
        #endif

        // set up ISR cause ISR_name mode
        attachInterrupt(digitalPinToInterrupt(GYRO_INTERRUPT), dmpDataReady, RISING);
        mpuIntStatus = mpu.getIntStatus();

        // set our DMP Ready flag so the main loop() function knows it's okay to use it
        #ifdef SERIAL_ENABLED
        Serial.println(F("DMP ready! Waiting for first interrupt..."));
        #endif
        dmpReady = true;

      
        // get expected DMP packet size for later comparison
        packetSize = mpu.dmpGetFIFOPacketSize();
    } else {
        // ERROR!
        // 1 = initial memory load failed
        // 2 = DMP configuration updates failed
        // (if it's going to break, usually the code will be 1)
        #ifdef SERIAL_ENABLED
        Serial.print(F("DMP Initialization failed (code "));
        Serial.print(devStatus);
        Serial.println(F(")"));
        #endif
    }

    delay(10000);
    /*-----------------------------------------*/
      // reserve 4 bytes for the input strings:
    throttleString.reserve(4);
    yawString.reserve(4);
    pitchString.reserve(4);
    rollString.reserve(4);
    
    pinMode(SERIAL_INTERRUPT,OUTPUT);    //Interrupt for serial comms
    digitalWrite(SERIAL_INTERRUPT,LOW);  
    
    Serial1.begin(57600);
    //Serial.println("Setup Complete");
    //Serial.println("Waiting for non-zero throttle");
    while(throttleInput == 0)
    {
      pulse();
      serialEvent();
      delay(100);
    }
    //Serial.println("Non-zero throttle acquired, entering loop");
    init_pwm();     //initialise pwm to 400Hz 5 to 10% duty 
   
    digitalWrite(LED_PIN, HIGH);
}



// ================================================================
// ===                    MAIN PROGRAM LOOP                     ===
// ================================================================

void loop() {
  
    // if programming failed, don't try to do anything
    if (!dmpReady) return;



    // wait for MPU interrupt or extra packet(s) available
    while (!mpuInterrupt && fifoCount < packetSize) {
        

        previous_time = time_elapsed;
        time_elapsed = millis();
        delta_time = time_elapsed - previous_time;

        //get gyro data
        gyroYawPrev = gyroYaw;
        gyroYaw = ypr[0] * 180/PI;
        gyroYaw = (gyroYaw - gyroYawPrev)/delta_time; 
        gyroPitch = (ypr[1] * 180/PI);
        gyroRoll = (ypr[2] * 180/PI);
        #ifdef SERIAL_ENABLED
            Serial.print("ypr\t");
            Serial.print(gyroYaw);
            Serial.print("\t");
            Serial.print(gyroPitch);
            Serial.print("\t");
            Serial.println(gyroRoll);
         #endif

        serialEvent();
        // complete the string when a newline arrives:
        if (stringComplete) {
          printInt(); 
          stringComplete = false;
          pulse();  
        } 
      
       throttle = rawToThrottle(throttleInput);
       targetYaw = rawToAngle(yawInput);
       targetPitch = rawToAngle(pitchInput);
       targetRoll = rawToAngle(rollInput);

         #ifdef SERIAL_ENABLED
            Serial.print("target typr\t");
            Serial.print(throttle);
            Serial.print("\t");
            Serial.print(targetYaw);
            Serial.print("\t");
            Serial.print(targetPitch);
            Serial.print("\t");
            Serial.println(targetRoll);
            Serial.print("delta_time: ");
            Serial.println(delta_time);
         #endif

       //apply PID
       pidYaw = yawPID.updatePID(targetYaw, constrain(gyroYaw,-50,50), delta_time);
       pidPitch = pitchPID.updatePID(targetPitch, constrain(gyroPitch,-50,50), delta_time);
       pidRoll = rollPID.updatePID(targetRoll, constrain(gyroRoll,-50,50), delta_time);

        #ifdef SERIAL_ENABLED
            Serial.print("PID ypr\t");
            Serial.print(pidYaw);
            Serial.print("\t");
            Serial.print(pidPitch);
            Serial.print("\t");
            Serial.println(pidRoll);
         #endif
       
      //update motors
       if(throttle==0 || gyroRoll>80 || gyroRoll < -80 || gyroPitch > 80 || gyroPitch < -80)
       {
          setMotors(0,0,0,0);
          yawPID.resetError();
          pitchPID.resetError();
          rollPID.resetError();
       }
       else
       {
        setMotors(throttle,pidYaw, pidPitch, pidRoll);
       }
    }

    

    // reset interrupt flag and get INT_STATUS byte
    mpuInterrupt = false;
    mpuIntStatus = mpu.getIntStatus();


    // get current FIFO count
    fifoCount = mpu.getFIFOCount();

    // check for overflow (this should never happen unless our code is too inefficient)
    if ((mpuIntStatus & 0x10) || fifoCount == 1024) {
        // reset so we can continue cleanly
        mpu.resetFIFO();
        #ifdef SERIAL_ENABLED
        Serial.println("FIFO overflow!");
        #endif

    // otherwise, check for DMP data ready interrupt (this should happen frequently)
    } else if (mpuIntStatus & 0x02) {
        // wait for correct available data length, should be a VERY short wait
        while (fifoCount < packetSize) fifoCount = mpu.getFIFOCount();

        // read a packet from FIFO
        mpu.getFIFOBytes(fifoBuffer, packetSize);
        
        // track FIFO count here in case there is > 1 packet available
        // (this lets us immediately read more without waiting for an interrupt)
        fifoCount -= packetSize;
        
        #ifdef OUTPUT_READABLE_YAWPITCHROLL
            // display Euler angles in degrees
            mpu.dmpGetQuaternion(&q, fifoBuffer);
            mpu.dmpGetGravity(&gravity, &q);
            mpu.dmpGetYawPitchRoll(ypr, &q, &gravity);
            // #ifdef SERIAL_ENABLED
            // Serial.print("ypr\t");
            // Serial.print(ypr[0] * 180/M_PI);
            // Serial.print("\t");
            // Serial.print(ypr[1] * 180/M_PI);
            // Serial.print("\t");
            // Serial.println(ypr[2] * 180/M_PI);
            // #endif
        #endif

        #ifdef OUTPUT_READABLE_REALACCEL
            // display real acceleration, adjusted to remove gravity
            mpu.dmpGetQuaternion(&q, fifoBuffer);
            mpu.dmpGetAccel(&aa, fifoBuffer);
            mpu.dmpGetGravity(&gravity, &q);
            mpu.dmpGetLinearAccel(&aaReal, &aa, &gravity);
            #ifdef SERIAL_ENABLED
            Serial1.print("areal\t");
            Serial1.print(aaReal.x);
            Serial1.print("\t");
            Serial1.print(aaReal.y);
            Serial1.print("\t");
            Serial1.println(aaReal.z);
            #endif
        #endif

        #ifdef OUTPUT_READABLE_WORLDACCEL
            // display initial world-frame acceleration, adjusted to remove gravity
            // and rotated based on known orientation from quaternion
            mpu.dmpGetQuaternion(&q, fifoBuffer);
            mpu.dmpGetAccel(&aa, fifoBuffer);
            mpu.dmpGetGravity(&gravity, &q);
            mpu.dmpGetLinearAccel(&aaReal, &aa, &gravity);
            mpu.dmpGetLinearAccelInWorld(&aaWorld, &aaReal, &q);
            #ifdef SERIAL_ENABLED
            Serial1.print("aworld\t");
            Serial1.print(aaWorld.x);
            Serial1.print("\t");
            Serial1.print(aaWorld.y);
            Serial1.print("\t");
            Serial1.println(aaWorld.z);
            #endif
        #endif
    


        // blink LED to indicate activity
        blinkState = !blinkState;
        digitalWrite(LED_PIN, blinkState);
    }
}

void printInt(void)
{
    Serial1.print("Packet Received:");
    Serial1.print("t");
    Serial1.print(throttleInput);
    Serial1.print("y");
    Serial1.print(yawInput);
    Serial1.print("p");
    Serial1.print(pitchInput);
    Serial1.print("r");
    Serial1.print(rollInput);
    Serial1.print("\tt");
    Serial1.print((int)rawToThrottle(throttleInput));
    Serial1.print("y");
    Serial1.print((int)rawToThrottle(yawInput));
    Serial1.print("p");
    Serial1.print((int)rawToThrottle(pitchInput));
    Serial1.print("r");
    Serial1.println((int)rawToThrottle(rollInput));
    
    
    return;
}


void serialEvent(void) {
  while (Serial1.available()) {
    // get the new byte:
    char inChar = (char)Serial1.read();
    // add it to the input string selected by setValue:
    // if the incoming character is a newline, set a flag
    // so the main loop can do something about it:
    if (inChar == '\n') 
    {
      stringComplete = true;  
      throttleInput = throttleString.toInt();
      yawInput = yawString.toInt();
      pitchInput = pitchString.toInt();
      rollInput = rollString.toInt();
      throttleString = "";
      yawString = "";
      pitchString = "";
      rollString = "";
    }
    else
    {
      if(inChar == 't' ||inChar == 'y'||inChar == 'p'||inChar == 'r')
      {
        packetFlag= inChar;
      }
      else{
        switch (packetFlag) {
          case THROTTLE_ID://throttle
            throttleString += inChar;
            break;
          case YAW_ID: //yaw
            yawString += inChar;
            break;
          case PITCH_ID: //pitch 
            pitchString += inChar;
            break;
          case ROLL_ID: //roll
            rollString += inChar;
            break;
        }
      }
    }
  }
  return;
}

void pulse(void)
{
  digitalWrite(SERIAL_INTERRUPT,HIGH);
  delayMicroseconds(1);
  digitalWrite(SERIAL_INTERRUPT,LOW);
  return;
}
