ibro-rox/D4-Ganges/Comms/Combined_interface_comms/drone/rfm12_config.h

/**** RFM 12 library for Atmel AVR Microcontrollers *******
 * 
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
 * @author Peter Fuhrmann, Hans-Gert Dahmen, Soeren Heisrath
 */

/******************************************************
 *                                                    *
 *           C O N F I G U R A T I O N                *
 *                                                    *
 ******************************************************/

/*
	Connect the RFM12 to the AVR as follows:

	RFM12           | AVR
	----------------+------------
	SDO             | MISO
	nIRQ            | INT0
	FSK/DATA/nFFS   | VCC
	DCLK/CFIL/FFIT  |  -
	CLK             |  -
	nRES            |  -
	GND             | GND
	ANT             |  -
	VDD             | VCC
	GND             | GND
	nINT/VDI        | -
	SDI             | MOSI
	SCK             | SCK
	nSEL            | Slave select pin defined below
*/


/************************
 * PIN DEFINITIONS
 */

//Pin that the RFM12's slave select is connected to
#define DDR_SS DDRB
#define PORT_SS PORTB
#define BIT_SS 4

//SPI port
#define DDR_SPI DDRB
#define PORT_SPI PORTB
#define PIN_SPI PINB
#define BIT_MOSI 5
#define BIT_MISO 6
#define BIT_SCK  7
#define BIT_SPI_SS 4
//this is the hardware SS pin of the AVR - it 
//needs to be set to output for the spi-interface to work 
//correctly, independently of the CS pin used for the RFM12


/************************
 * RFM12 CONFIGURATION OPTIONS
 */

//baseband of the module (either RFM12_BAND_433, RFM12_BAND_868 or RFM12_BAND_912)
#define RFM12_BASEBAND RFM12_BAND_433

//center frequency to use (+-125kHz FSK frequency shift)
#define FREQ 433175000UL

//use this for datarates >= 2700 Baud
#define DATARATE_VALUE RFM12_DATARATE_CALC_HIGH(9600.0)

//use this for 340 Baud < datarate < 2700 Baud
//#define DATARATE_VALUE RFM12_DATARATE_CALC_LOW(1200.0)

//TX BUFFER SIZE
#define RFM12_TX_BUFFER_SIZE 30

//RX BUFFER SIZE (there are going to be 2 Buffers of this size for double_buffering)
#define RFM12_RX_BUFFER_SIZE 30


/************************
 * INTERRUPT VECTOR
 * set the name for the interrupt vector here
 */
 
//the interrupt vector
#define RFM12_INT_VECT (INT1_vect)

//the interrupt mask register
#define RFM12_INT_MSK EIMSK

//the interrupt bit in the mask register
#define RFM12_INT_BIT (INT1)

//the interrupt flag register
#define RFM12_INT_FLAG EIFR

//the interrupt bit in the flag register
#define RFM12_FLAG_BIT (INTF1)

//setup the interrupt to trigger on negative edge
#define RFM12_INT_SETUP()   EICRA |= (1<<ISC11)


/************************
 * FEATURE CONFIGURATION
 */

#define RFM12_LIVECTRL 0
#define RFM12_NORETURNS 0
#define RFM12_NOCOLLISIONDETECTION 1
#define RFM12_TRANSMIT_ONLY 0
#define RFM12_SPI_SOFTWARE 0
#define RFM12_USE_POLLING 0
#define RFM12_RECEIVE_ASK 0
#define RFM12_TRANSMIT_ASK 0
#define RFM12_USE_WAKEUP_TIMER 0
#define RFM12_LOW_POWER 0


/************************
 * UART DEBUGGING
 * en- or disable debugging via uart.
 */
 
#define RFM12_UART_DEBUG 0
