ibro-rox/D4-Ganges/Comms/Uplink_Double_Transceiver/base/basestation_comms.c

#include <avr/io.h>
#include <stdio.h>
#include <avr/interrupt.h>
#include <util/delay.h>
#include <math.h>

#include "rfm12.h"
#include "basestation_comms.h"

volatile uint8_t encryption_key;

int main(void)
{
	// Initialise rfm12 and interrupts
	rfm12_init_rx();
	rfm12_init_tx();
	sei();

	uint8_t receivedpackettype;
	uint16_t receiveddata;

	encryption_key = 5;

	// Send test data
	uint16_t testdata = 0;

	while (1)
	{
		rfm12_tick(0);

		#if UPLINK_TEST
			Send_data(OP_ROLL, testdata);
			testdata++;
			if (testdata == 1024) break;
			_delay_ms(50);

			char txString[100];
			sprintf(txString, "Transmitting: packet type %u and data %u\n", OP_ROLL, testdata);
			send_string(txString);
		#endif
		
		if (rfm12_rx_status() == STATUS_COMPLETE)
		{
			// Get the received packet type and data
			receivedpackettype = rfm12_rx_type();
			receiveddata = *rfm12_rx_buffer();

			// Decrypt (if enabled) and extract 10-bit data and packet type from the received packet 
			Retrieve_data(&receivedpackettype, &receiveddata);

			#if UPLINK_TEST
				// Send data to UART
				char rxString[100];
				sprintf(rxString, "Received: packet type %u and data %u\n", receivedpackettype, receiveddata);
				send_string(rxString);
			#endif
		}
	}
	while (1) {};
	
}

void Retrieve_data(uint8_t* type, uint16_t* data)
{
	// Combine packet type and data into a single 16-bit int
	uint16_t totalpacket;
	totalpacket = *type;
	totalpacket = (totalpacket << DATA_BIT_SIZE) + *data;

#if ENCRYPTION_ENABLED
	// Decrypt the received packet
	totalpacket = Decrypt_data(totalpacket);
#endif // ENCRYPTION_ENABLED


	// Split the decrypted packet into the data and the packet type
	Decode_data(type, data, totalpacket);
}

void Decode_data(uint8_t* type, uint16_t* data, uint16_t totalpacket)
{
	// Get 10-bit data from the 16 bit packet
	*data = totalpacket & (uint16_t)1023;

	// Get packet type
	*type = (totalpacket >> DATA_BIT_SIZE);
}

uint16_t Decrypt_data(uint16_t packet)
{
	// Retrieve the encryption key
	uint8_t encryption_key;
	encryption_key = (packet >> (DATA_BIT_SIZE + COMMAND_BIT_SIZE));

	// Retrieve bits that are shifted out when the left shift is done
	uint8_t rotated_out_bits;
	rotated_out_bits = (packet >> (DATA_BIT_SIZE + COMMAND_BIT_SIZE - encryption_key));

	// Get completely rotated bits by adding the shifted out bits to the
	// original packet left-shifted by the required number of bits.
	// It is & with a sequence of 1s to remove the encryption key from the overall packet
	uint16_t decrypted_packet;
	decrypted_packet = ((packet << encryption_key) & ((uint16_t)pow(2, DATA_BIT_SIZE + COMMAND_BIT_SIZE) - 1)) + rotated_out_bits;

	return decrypted_packet;
}

//!
/*
Process data and send it to the transceiver for transmission.
If encryption is enabled in the basestation_comms.h then the data will be encrypted.
The 10-bit data is encoded such that the 2 MSBs are stored in the packet type.
*/
void Send_data(uint8_t type, uint16_t data)
{
	// Combine packet type and data into a single 16-bit int
	uint16_t totalpacket;
	totalpacket = type;
	totalpacket = (totalpacket << DATA_BIT_SIZE) + data;

	// Encrypt data
	#if ENCRYPTION_ENABLED
		totalpacket = Encrypt_data(totalpacket);
	#endif

	// Split 16-bit packet into two 8-bit ints - packet type and data
	uint8_t datapacket;
	Encode_data(&type, &datapacket, totalpacket);

	// Send packet to the buffer for transmission
	rfm12_tx(sizeof(datapacket), type, &datapacket);
}

//!
/*
Encode the total packet into the type and data
*/
void Encode_data(uint8_t* type, uint8_t* data, uint16_t totalpacket)
{
	// Data is equal to the 8 LSBs
	*data = totalpacket;

	// Type, encryption key and 2 bits of data are held in the 8 MSBs
	*type = (totalpacket >> DATA_BIT_SIZE);
}

//!
/*
Encrypt the packet type and data using an encryption key.
This encryption key changes every time the data is encrypted.
*/
uint16_t Encrypt_data(uint16_t packet)
{
	// Retrieve bits that are shifted out when the right shift is done
	uint8_t rotated_out_bits;
	rotated_out_bits = (packet & ((uint8_t)pow(2, encryption_key) - 1));

	// Get completely rotated bits by adding the shifted out bits to the
	// original packet right-shifted by the required number of bits.
	uint16_t encrypted_packet;
	encrypted_packet = (packet >> encryption_key) + (rotated_out_bits << (COMMAND_BIT_SIZE + DATA_BIT_SIZE - encryption_key));

	// Add on the encryption key to the MSBs of the packet
	encrypted_packet = encrypted_packet + (encryption_key << (COMMAND_BIT_SIZE + DATA_BIT_SIZE));

	// Adjust encryption key for next transmission
	encryption_key = (encryption_key < 3) ? encryption_key + 5 : encryption_key - 3;
	if (encryption_key == 0) encryption_key = 5;

	return encrypted_packet;
}

// Mohammed's UART code
#define BAUD 9600                                   // define baud
#define BAUDRATE ((F_CPU)/(BAUD*16UL)-1)            // set baud rate value for UBRR

void init_uart1()// initialize UART
{
	//1. set the baud rate, lets configure to 9600;
	// set the baud rate registers Ref: [1],[2]
	UBRR0H = BAUDRATE >> 8;// UBRRnH is 8 bits left
	UBRR0L = BAUDRATE;

	//2. setting up data packet: 8 bits ,no parity 1 stop bit
	// setting 8 bits got to UCSCR register Ref:[3], pg 185 of data sheet

	UCSR0C = _BV(UCSZ00) | _BV(UCSZ01); // 8 bits, USBS1 = 0 for 1 stop bit

										// note: havnt set up the stop bit in Ref [2] slides
										// 3. from Ref[2] we now enable Transmission and receive n UCSRnB register
	UCSR0B = _BV(TXEN0) | _BV(RXEN0);
}

void uart_transmit(char data)
{
	while (!(UCSR0A &  _BV(UDRE0))); //  data register enable bit is 1 if tx buffer is empy
									 // if its 1 we load data onto UDR- Uart Data Register(buffer)
	UDR0 = data;
}

void send_string(char *str)
{
	int i;
	for (i = 0; str[i]; i++) uart_transmit(str[i]);
}
//
