ibro-rox/D4-Ganges/Comms/Hosted interface/embedded_coms.c

/* embedded_coms.c
 *
 *  Author: Steve Gunn & Klaus-Peter Zauner 
 * Licence: This work is licensed under the Creative Commons Attribution License. 
 *          View this license at http://creativecommons.org/about/licenses/
 *   Notes: 
 *          - Use with host_coms_boost.c
 *  
 *          - F_CPU must be defined to match the clock frequency
 *
 *          - Compile with the options to enable floating point
 *            numbers in printf(): 
 *               -Wl,-u,vfprintf -lprintf_flt -lm
 *
 *          - Pin assignment: 
 *            | Port | Pin | Use                         |
 *            |------+-----+-----------------------------|
 *            | A    | PA0 | Voltage at load             |
 *            | D    | PD0 | Host connection TX (orange) |
 *            | D    | PD1 | Host connection RX (yellow) |
 *            | D    | PD7 | PWM out to drive MOSFET     |
 */

#include <stdio.h>
#include <avr/io.h>
#include <util/delay.h>
#include <math.h>

#define DELAY_MS      500
#define BDRATE_BAUD  9600

#define BUFFSIZE      200

void init_stdio2uart0(void);
int uputchar0(char c, FILE *stream);
int ugetchar0(FILE *stream);


		

int main(void)
{
	uint16_t cnt =0;

	char cmd[BUFFSIZE];	
	int prm;
	int res;
	

        	
	init_stdio2uart0();

	printf("\r\nIlMatto Coms READY!\r\n");

	for(;;) {
	   res = scanf("%s %u", cmd, &prm);
	   printf("%04d: CMD was: \"%s\" with %d (%d)\r\n", cnt++, cmd, prm, res);	    
	}
}

int uputchar0(char c, FILE *stream)
{
	if (c == '\n') uputchar0('\r', stream);
	while (!(UCSR0A & _BV(UDRE0)));
	UDR0 = c;
	return c;
}

int ugetchar0(FILE *stream)
{
	while(!(UCSR0A & _BV(RXC0)));
	return UDR0;
}

void init_stdio2uart0(void)
{
	/* Configure UART0 baud rate, one start bit, 8-bit, no parity and one stop bit */
	UBRR0H = (F_CPU/(BDRATE_BAUD*16L)-1) >> 8;
	UBRR0L = (F_CPU/(BDRATE_BAUD*16L)-1);
	UCSR0B = _BV(RXEN0) | _BV(TXEN0);
	UCSR0C = _BV(UCSZ00) | _BV(UCSZ01);

	/* Setup new streams for input and output */
	static FILE uout = FDEV_SETUP_STREAM(uputchar0, NULL, _FDEV_SETUP_WRITE);
	static FILE uin = FDEV_SETUP_STREAM(NULL, ugetchar0, _FDEV_SETUP_READ);

	/* Redirect all standard streams to UART0 */
	stdout = &uout;
	stderr = &uout;
	stdin = &uin;
}
