ibro-rox/D4-Ganges/Comms/Combined_interface_comms/comms.h

// Define codes for the different commands
#define OP_THRUST 0
#define OP_ROLL 1
#define OP_YAW 2
#define OP_PITCH 3
#define OP_BUTTON 4

// K values sent to the controller
#define OP_KP_ROLL 5
#define OP_KI_ROLL 6
#define OP_KD_ROLL 7
#define OP_KP_YAW 8
#define OP_KI_YAW 9
#define OP_KD_YAW 10
#define OP_KP_PITCH 11
#define OP_KI_PITCH 12
#define OP_KD_PITCH 13

// Telemetery sent back from the drone
#define OP_BATTERY_LEVEL 14
#define OP_ANGLE_X 15
#define OP_ANGLE_Y 16
#define OP_ANGLE_Z 17
#define OP_TELEMETRY_ACKNOWLEDGE 18
#define OP_IR_SENSOR 19
#define OP_NULL 63

// K value size
#define CHAR_MAX 6

// Define data code for the button command
#define BTN_CARGO_HOOK_UP 0
#define BTN_CARGO_HOOK_DOWN 1
#define	BTN_PID_MODE 2 // Allow setting of K values and disable telemetry
#define	BTN_FLIGHT_MODE 3 // Receive telemetry
#define BTN_POWER_ON 4
#define BTN_POWER_OFF 5

// ADC pin definitions
//		Base-side
#define	PIN_THRUST 0
#define	PIN_ROLL 1
#define	PIN_YAW 2
#define	PIN_PITCH 3
//		Drone-side
#define PIN_BATTERY 0
#define PIN_IR_SENSOR 1

// Define bit sizes for the packets
#define DATA_BIT_SIZE 10
#define COMMAND_BIT_SIZE 5
#define ENCRYPT_KEY_BIT_SIZE 1

// Enable telemetry back to the base
#define ENABLE_TELEMETRY 1

// Enable the cargo hook
#define ENABLE_CARGO_HOOK 1

// Enable encryption
#define ENABLE_ENCRYPTION 1

// Enable/configure UI and setting K values
#define ENABLE_UI 1
#define K_RANGE_MIN 0
#define K_RANGE_MAX 10.23

// Enable controls
#define ENABLE_CONTROLS 1

// Enable isolated uplink/downlink tests
#define UPLINK_TEST 0
#define DOWNLINK_TEST 0
