ibro-rox/D4-Ganges/(commit log)

2017-02-24 added current il-matto files and ChassisDesign folder
2017-02-24 moved sheet into admin folder
    [Ganges_Requisitions.xlsx]
2017-02-24 Uploaded initial chassis design and downlink coms
    Uploaded initial chassis design and downlink coms
2017-02-25 moved chassis design to correct folder
2017-02-25 changes to chassis design
2017-02-25 most of drone chassis is done
2017-02-25 I2C Attempts
    Most of this doesnt work, however there does appear to be some I2C comms
    going on - even if no data is received yet.
2017-02-25 Started uplink comms code
    Started code for the uplink communications - added the rfm12 library and
    created files for the basestation and the drone. Also created a test
    file to try using 2 of the packet type bits to hold the 2 MSBs from the
    10-bit ADC output.
2017-02-25 Added timesheet hours
    Added timesheet hours for 24th and 25th Feb
    [ganges_timesheet.xlsx]
2017-02-25 Added AVR-MPU6050 Library
    Added library from http://davidegironi.blogspot.co.uk/2013/02/avr-atmega-mpu6050-gyroscope-and.html#.WLGv1juLQuU
    [atmega8_mpu6050_sample.sch]
2017-02-25 tidy up of pwm test before changing for esc
2017-02-26 pwm code for esc's implemted
2017-02-26 Add files via upload
    Preliminary version of High Level Block Schematic
2017-02-26 26/2/17: Added remote code which atm reads 4 potentiometers(thrust,pitch,ywa,roll)
    Included transceivers headers and source codes along with this
    controller code in same directory(sort off). Src folder which has
    rtc12.h and rtc12.c which contains the main contents of initializing and
    setting up the transceivers. Still yeet to integrate with the
    transceiver functions but the resources are available to use them
2017-02-26 Uart uart init and transmit functions back to base_controller
2017-02-26 Added AVR Library Code
    [atmega8_mpu6050_sample.sch]
2017-02-26 updated code for pwm and created new PWM code for leonardo
2017-02-26 wrote a bit of downlink code as well in base_station
    but there is a the uplink problem where there is a handshake issue where
    the transmission of successive data will happen fast it wont give
    receiver time to read from buffer process it and emty the recive buffer
    in the drone to allow it to get ready to receive the next transmitted
    value. Either do delay in base station when u transmitted a data to give
    time for the receiver to get ready or do handshake.
    [base_station_controller.c, receiver_pwm_read.c, rfm12_config.h]
2017-02-26 Finished encoding and adjusted library for two SPI slave transceivers
    Completed preliminary comms code with encoding and decoding to 10 bits.
    Changed enums to define statements.
    Adjusted copy of the library to use two slave transceivers -
    successfully compiles but not tested for functionality. Needs to be
    checked through.
2017-02-26 avr-lib-test
    avr-lib-test is the only important one here. Replaced the UART code in
    the MPU6050 library with the UART stream reassignment from the C7 Lab
    last year - now data can be read from the MPU6050
    [debug.h, debug_main.c, main.c, manual_i2c.c, mpu6050.c, mpu6050.h]
2017-02-26 IR code for Il Matto with a serial interface
    Code for Sharp 2y0a21 IR sensor module. Uses ADC on pin A0. Scaling
    factor of the voltage value found to be 24 by calibrating the sensor at
    a known distance. Output displayed in PuTTy.
2017-02-26 Added working MPU6050 test
    Replaced UART code with the stream-redirect stuff from last years C7 Lab
    [debug.h, debug_main.c, mpu6050.c, mpu6050.h]
2017-02-27 General admin stuff
    [Ganges_Requisitions.xlsx, ganges_timesheet.xlsx]
2017-02-27 Updated Requisitions Form
    [Ganges_Requisitions.xlsx]
2017-02-27 adding file for PID controller
2017-02-27 Updated Requisitions
    [Ganges_Requisitions.xlsx]
2017-02-27 added i2c arduino library
    [l.obj]
2017-02-27 updated arduino mpu-6050 library
2017-02-27 Finished edit of RFM12 library
    Finished editing the RFM12 library to use two slave transceivers.
    Switched 'up' and 'down' to 'rx' and 'tx' in the code to make it clearer
    for use on both the drone and the basestation. tick() no longer required
    for the receiver.
    Adjusted basestation and drone comms to use the new library.
    [Basestation_comms.c, drone_comms.c, rfm12_config.h]
2017-02-27 Updated timesheet
    Added my hours to the timesheet
    [ganges_timesheet.xlsx]
2017-02-27 Deleted all unnecessary library files in i2cdevlib-master, and updated the basic Git Shell Commands file
    [l.obj]
2017-02-27 added example PID files and set up leonardo file
2017-02-27 Pointless servo control using IR sensor
2017-02-27 2/27/17 report
    Only focused on interface wit pc trying to spend a lot of time testing
    my uart to communicate with my pc and then got the comms between pc and
    ilmatto to work.
    The attempted to enter floating point values which had to do manual
    conversion to transmittable form (int or uint16_t).
    We will most likely stick between between 0-10.24 so its programmed it
    only take this range. These values get converted to int ish and that
    gets passed to joels functions wich takes taakes it and converts and
    splits its 10-bit equivlent to the 8 bit at data packet and 2 bit to the
    datatype.
2017-02-27 Updated timesheet
    Updated timesheet
    [ganges_timesheet.xlsx]
2017-02-28 added more files for pid and slowly converting to code that we can use
2017-02-28 made code compilable, need to get funtions from others, Implement PWM and data class that will convert and store all values
2017-02-28 small updates to pid code
2017-02-28 Reverted to outputting yaw/pitch/roll instead of quaternions
2017-02-28 Started Investigation into removal of the 'data ready' interrupts
2017-02-28 Final Requisitions submitted at 12:30
    [Ganges_Requisitions.xlsx]
2017-02-28 Updated Timesheet
    [ganges_timesheet.xlsx]
2017-02-28 reverted AccelGyro files, as removing interrupts caused data corruption
    [AccelGyro.ino]
2017-02-28 7added mounts for servo and sensor, also made adjustemts to heights of supports
2017-02-28 added more files attemtpted to implemet PWM
2017-03-01 User interface developed
    -made UI which accepts p or i or d and floating numbers in range
    0-10.23.
    - did some safety measure like check range
    - re-enter values in case u entered an un-intentional values
    - prevents the k value array from storing nunmbers in case u enter
    numbers when asked to enter p or i or d
    - also aksed u to enter re -enter p or i or d in case u enter different
    letters like 'o' or 'f' etc
    - tested that this UI in the il matto whihc is based on if statements
    and interrupts doesnt block the controller from transmitting joystick
    values for a significant amount of time
    [PID_values_test.c, PID_values_test_2.c, development_base_station.c]
2017-03-01 made corrections to 'final' design and exported as DXF file
    [Laser_cutting_design_4.dxf, Laser_cutting_design_4_1.dxf]
2017-03-01 got to a 'working pid controller'(compiles with no errors) uses a PID class made by someome else so need to be wary of errors. This is currently made for using PWM with the esc's
    [Definitions.h, PID.cpp, PID.h, PWM.cpp, PWM.h, leonardoPID2.ino, utils.cpp]
2017-03-01 Test prgrams for wireless comms
    Combined the test codes for base and drone which were coded by Joel.
    Then simply added the uart and adc bits on the code after analysing
    Joels implementation and understanding it well.
2017-03-01 Risk assessment and timesheet update
    [ganges_timesheet.xlsx]
2017-03-01 simple test program used to check conversion of 10 bit number to angle/throttle
2017-03-02 Little serial test program for arduino/il matto interface
2017-03-02 made changes for sensors to fit and servo, also increased length of legs
2017-03-02 fixing timesheet issue
    [ganges_timesheet.xlsx]
2017-03-02 fixed timesheet and added my hours
    [ganges_timesheet.xlsx]
2017-03-02 Finished comms code for test 1
    Test 1 for tomorrows lab (2/3/17) include :+1:
    - for testing uplink
    - for testing adc values for 4 channels if uplink works
2017-03-02 Updated #
    [Ganges_Requisitions.xlsx, Laser_cutting_design_4.dxf, Laser_cutting_design_4_1.dxf, atmega8_mpu6050_sample.sch, ganges_timesheet.xlsx]
2017-03-02 sorry for the bad commit but most of this is just formatting for the code submission
    [Laser_cutting_design_4.dxf, Laser_cutting_design_4_1.dxf]
2017-03-02 Added Chassis Design Proposal
    [Ganges_Requisitions.xlsx, Laser_cutting_design_4.dxf, Laser_cutting_design_4_1.dxf, atmega8_mpu6050_sample.sch, ganges_timesheet.xlsx]
2017-03-02 Updated PPF with chassis design module
2017-03-02 Finished double transceiver test. Added design completion milestones.
    Finished double transceiver test. Added comments to source code files.
    Added design completion milestones.
    Ensured comms tests are compilable and corrected code.
    [10bit_to_8bit_test.c, Basestation_comms.c, basestation_comms.c, basestation_comms.h, comms.h, drone_comms.c, drone_comms.h, encode_test.c]
2017-03-03 Integrated PID control with Gyro Data
2017-03-03 extra files and a couple of changes
2017-03-03 fixed code to work with 50Hz 1-2ms pulse
    [leonardoPWM.ino]
2017-03-03 making code more versatile to cover different length pwm widths
2017-03-04 Servo .hex and .elf files
2017-03-04 Arduino receive side update
2017-03-04 Il matto test code, transmit packet of data on external pin interrupt
2017-03-04 working with servo and working PID loop
2017-03-04 moved PWM test into seperate folder so I can start work on esc code
2017-03-04 ESCPID/
    Adeed ESCPID folder so I can startwork on the ESC when we get them
2017-03-04 getting code ready for ESC PWM
2017-03-04 Slight change to tuning of IR sensor
2017-03-05 COMMS ACTUALLY WORKS!!!!!!!
    In this code the comms successfully transmits and receives in sync.
    Drone polls, base doesn't.
    [basestation_comms.c, comms.h, rfm12_config.h, test1_basestation_comms.c, test1_drone_comms.c]
2017-03-05 Eagle Library for Ganges
    [onboard_v1.0.sch]
2017-03-05 Increased UART BAUD rate to achieve required rate
    Increased UART BAUD rate to 57600. Now achieves required packet rate.
2017-03-05 UPLINK WORKS WITH UART BAUD 57600 to get 100 packs per sec
2017-03-05 Final schematic components
2017-03-06 Updated to include pulse() for triggering interrupt
2017-03-06 Changed to zhiyb library for RFM12B's
    Comms works at >100 packets/s using new library and sending each packet
    twice. No UART in the transmitter, only delays.
2017-03-06 Uploaded RFM12 to Il Matto and gyro to Arduino pins
    Uploaded RFM12 to Il Matto and gyro to Arduino pins
2017-03-06 Latest schematic update
    [onboard_v1.0.sch]
2017-03-06 Added solidworks of hook mchanism
    [15mm_Pin.SLDPRT, Chassis Base.SLDPRT, HOOK.SLDPRT, HookAssembly.SLDASM]
2017-03-06 moved pin file to correct folder
2017-03-06 added esc pins
2017-03-06 updated controller for 3mm acrylic
2017-03-06 Drone code for receiving pot values, sending telemetry and updated timesheet
    test1 for drone receives potentiometer values. test3 receives
    potentiometer values and sends telemetry back at 1/s (intermittent).
    test3 also successfully implements encryption and decryption for both
    directions.
    Also updated timesheet.
    [ganges_timesheet.xlsx]
2017-03-06 Update of System schematic
    [onboard_v1.0.sch]
2017-03-06 Finalised first version of low level schematic
    [onboard_v1.0.sch]
2017-03-07 Added servoCam files for adjusting the hook position
    [ServoCam.DWG, ServoCam.DXF, ServoCam.SLDPRT, cargo cam.DXF]
2017-03-07 testing different values to work with ESC's
2017-03-08 changed prescalar for PWM hopefully should now be 400Hz rather than 50Hz
2017-03-08 added il matto library code (working)
2017-03-08 updated other files
    [15mm_Pin.SLDPRT, Chassis Base.SLDPRT, Ganges_Requisitions.xlsx, HOOK.SLDPRT, HookAssembly.SLDASM, Laser_cutting_design_4.dxf, Laser_cutting_design_4_1.dxf, ServoCam.DWG]
2017-03-08 made corrections to work with expected input signals
    [AccelGyro.ino, Definitions.h, PWM.cpp, leonardoPWM_input.ino]
2017-03-08 re added working arduino file
2017-03-08 Added combined comms and serial interface code.
    Implemented new encryption method, added PID/flight mode switch and
    print new k values.
2017-03-08 Reuploaded comms and updated timesheet
    Reuploaded comms and updated timesheet
    [ganges_timesheet.xlsx]
2017-03-08 Leonardo-Il-Matto interface integrated with PWM output file
2017-03-08 Latest PWM arduino
2017-03-08 Modified PID loop to include IlM comms and a PDF of the schematic
2017-03-09 added some debug for the pwm
2017-03-09 UI integration with base station works
    -Implemented switch for hook
    - Did the switch control for switching betweeen PID mode (UI mode for
    sending k values) and flight mode(controlling drone with pots and
    receiving telemetry)
2017-03-09 Change pin 7 to pin 6 on arduino for serial interrupt
2017-03-09 Golden Critical Path Arduino sketch
2017-03-09 added in code to make yaw PID work on rate of change angles rather than absolute values
2017-03-10 Added timer to drone code for telemetry and battery level/angles
    Adjusted telemetry code to use a timer and send back angles as well as
    the current battery level.
2017-03-10 COMMS IS DONE ON MY SIDE
    test 4 does pots transmission with improved data rate, telemetry, ui and
    hook.
    test 5 includes everything from test 4 with addition of extra switch for
    power and decoding the received telemetry data and displaying the
    information (althought its not quite consistent as we lose packets now
    and then but we increased the downlink rate which doesnt seems to slow
    down the uplink data rate but its not too perfect solution for
    telemtry.)
2017-03-10 Calibration of debug program
2017-03-10 added static test for quad which has a propotional gain on the quad with no controller input, this was very useful for crushing bugs (it worked how we expected) these bugs will be outlined in next co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
    [AccelGyro.ino, Definitions.h, PID.cpp, PID.h, PWM.cpp, PWM.h, utils.cpp]
2017-03-10 large amount of bug fixing went on here... so first when throtte is set to zero the integral acummilation is set to zero as the pid is not active during this time so it just accumilated and ramped up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
    [AccelGyro.ino, PWM.cpp, PWM.h]
2017-03-11 testing last commit, wasnt recieving data these changes fixed that
    [AccelGyro.ino, PWM.cpp]
2017-03-11 Servo Calibration routine
2017-03-11 Uploaded USBasp driver app
2017-03-12 rewrote sequecnce to calibrate motors
2017-03-12 recalibrated gyroscope and added offset for gyro values, also added delay to allow gyro to settle before flight
2017-03-12 Servo position reading for calibrating the hook
2017-03-12 stable PITCH git commit ControlIntegration/ git commit ControlIntegration/
2017-03-13 Disabled pot button press, added kill switch functionality, added Battery level LED, IR sensor telemetry, cargo hook implentation
    Disabled pot button press, added kill switch functionality, added
    Battery level LED, IR sensor telemetry, cargo hook implentation
2017-03-14 New ESC calibration routine
2017-03-14 Created Control Flow Diagram for final report
2017-03-14 Added paragraph on the PID tuning procedure
2017-03-15 Random schematic temp file
2017-03-15 Absolute FINAL SCHEMATIC
    [onboard_v1.1.sch]
2017-03-16 Added challenge solution statement, updated specification to be more specification like. Some new items were added to spec, I am happy to discuss/remove these if needed. The first couple of paragraph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
2017-03-16 updated challenge solution statement
    [ServoCam.SLDDRW]
2017-03-16 Changes so far
    [pdb_v1.0.sch]
