ibro-rox/D4-Ganges/(notices)

Notices in the files:
Il-MattoExampleCode/leonardoPID/Engines.cpp:
This program is free software: you can redistribute it and/or modify
it under the terms of the GNU General Public License as published by
the Free Software Foundation, either version 3 of the License, or
(at your option) any later version.
Comms/Combined_interface_comms/drone/rfm12_config.h:
This software is free software; you can redistribute it and/or modify
it under the terms of the GNU General Public License as published
